AWDerh-Academia/MIE438-Microprocessors-and-Embedded-Microcontrollers/README.md

# Self-Levelling Cup Holder

(For MIE438)

# Authors

Abdul Derh \
Rakshit Sharma \
Tongwha Kim

# Demo

[YouTube Video](https://www.youtube.com/watch?v=ZMVGCV2L7J8&feature=youtu.be)
