AWDerh-Academia/MIE438-Microprocessors-and-Embedded-Microcontrollers/dis.asm

slc-vs.ino.elf:     file format elf32-avr


Disassembly of section .text:

00000000 <__vectors>:
       0:	1e c1       	rjmp	.+572    	; 0x23e <__ctors_end>
       2:	00 00       	nop
       4:	4d c1       	rjmp	.+666    	; 0x2a0 <__bad_interrupt>
       6:	00 00       	nop
       8:	4b c1       	rjmp	.+662    	; 0x2a0 <__bad_interrupt>
       a:	00 00       	nop
       c:	49 c1       	rjmp	.+658    	; 0x2a0 <__bad_interrupt>
       e:	00 00       	nop
      10:	47 c1       	rjmp	.+654    	; 0x2a0 <__bad_interrupt>
      12:	00 00       	nop
      14:	45 c1       	rjmp	.+650    	; 0x2a0 <__bad_interrupt>
      16:	00 00       	nop
      18:	43 c1       	rjmp	.+646    	; 0x2a0 <__bad_interrupt>
      1a:	00 00       	nop
      1c:	41 c1       	rjmp	.+642    	; 0x2a0 <__bad_interrupt>
      1e:	00 00       	nop
      20:	3f c1       	rjmp	.+638    	; 0x2a0 <__bad_interrupt>
      22:	00 00       	nop
      24:	3d c1       	rjmp	.+634    	; 0x2a0 <__bad_interrupt>
      26:	00 00       	nop
      28:	3b c1       	rjmp	.+630    	; 0x2a0 <__bad_interrupt>
      2a:	00 00       	nop
      2c:	39 c1       	rjmp	.+626    	; 0x2a0 <__bad_interrupt>
      2e:	00 00       	nop
      30:	37 c1       	rjmp	.+622    	; 0x2a0 <__bad_interrupt>
      32:	00 00       	nop
      34:	35 c1       	rjmp	.+618    	; 0x2a0 <__bad_interrupt>
      36:	00 00       	nop
      38:	33 c1       	rjmp	.+614    	; 0x2a0 <__bad_interrupt>
      3a:	00 00       	nop
      3c:	31 c1       	rjmp	.+610    	; 0x2a0 <__bad_interrupt>
      3e:	00 00       	nop
      40:	2f c1       	rjmp	.+606    	; 0x2a0 <__bad_interrupt>
      42:	00 00       	nop
      44:	03 c7       	rjmp	.+3590   	; 0xe4c <__vector_17>
      46:	00 00       	nop
      48:	2b c1       	rjmp	.+598    	; 0x2a0 <__bad_interrupt>
      4a:	00 00       	nop
      4c:	29 c1       	rjmp	.+594    	; 0x2a0 <__bad_interrupt>
      4e:	00 00       	nop
      50:	27 c1       	rjmp	.+590    	; 0x2a0 <__bad_interrupt>
      52:	00 00       	nop
      54:	25 c1       	rjmp	.+586    	; 0x2a0 <__bad_interrupt>
      56:	00 00       	nop
      58:	23 c1       	rjmp	.+582    	; 0x2a0 <__bad_interrupt>
      5a:	00 00       	nop
      5c:	26 c6       	rjmp	.+3148   	; 0xcaa <__vector_23>
      5e:	00 00       	nop
      60:	1f c1       	rjmp	.+574    	; 0x2a0 <__bad_interrupt>
      62:	00 00       	nop
      64:	ec c5       	rjmp	.+3032   	; 0xc3e <__vector_25>
      66:	00 00       	nop
      68:	c1 c5       	rjmp	.+2946   	; 0xbec <__vector_26>
      6a:	00 00       	nop
      6c:	19 c1       	rjmp	.+562    	; 0x2a0 <__bad_interrupt>
      6e:	00 00       	nop
      70:	17 c1       	rjmp	.+558    	; 0x2a0 <__bad_interrupt>
      72:	00 00       	nop
      74:	15 c1       	rjmp	.+554    	; 0x2a0 <__bad_interrupt>
      76:	00 00       	nop
      78:	13 c1       	rjmp	.+550    	; 0x2a0 <__bad_interrupt>
      7a:	00 00       	nop
      7c:	11 c1       	rjmp	.+546    	; 0x2a0 <__bad_interrupt>
      7e:	00 00       	nop
      80:	b8 c6       	rjmp	.+3440   	; 0xdf2 <__vector_32>
      82:	00 00       	nop
      84:	0d c1       	rjmp	.+538    	; 0x2a0 <__bad_interrupt>
      86:	00 00       	nop
      88:	0b c1       	rjmp	.+534    	; 0x2a0 <__bad_interrupt>
      8a:	00 00       	nop
      8c:	09 c1       	rjmp	.+530    	; 0x2a0 <__bad_interrupt>
      8e:	00 00       	nop
      90:	07 c1       	rjmp	.+526    	; 0x2a0 <__bad_interrupt>
      92:	00 00       	nop
      94:	05 c1       	rjmp	.+522    	; 0x2a0 <__bad_interrupt>
      96:	00 00       	nop
      98:	03 c1       	rjmp	.+518    	; 0x2a0 <__bad_interrupt>
      9a:	00 00       	nop
      9c:	04 c7       	rjmp	.+3592   	; 0xea6 <__vector_39>
      9e:	00 00       	nop
      a0:	ff c0       	rjmp	.+510    	; 0x2a0 <__bad_interrupt>
      a2:	00 00       	nop
      a4:	fd c0       	rjmp	.+506    	; 0x2a0 <__bad_interrupt>
      a6:	00 00       	nop
      a8:	77 c6       	rjmp	.+3310   	; 0xd98 <__vector_42>
      aa:	00 00       	nop
      ac:	f9 c0       	rjmp	.+498    	; 0x2a0 <__bad_interrupt>
      ae:	00 00       	nop
      b0:	f7 c0       	rjmp	.+494    	; 0x2a0 <__bad_interrupt>
      b2:	00 00       	nop
      b4:	f5 c0       	rjmp	.+490    	; 0x2a0 <__bad_interrupt>
      b6:	00 00       	nop
      b8:	f3 c0       	rjmp	.+486    	; 0x2a0 <__bad_interrupt>
      ba:	00 00       	nop
      bc:	40 c6       	rjmp	.+3200   	; 0xd3e <__vector_47>
      be:	00 00       	nop
      c0:	ef c0       	rjmp	.+478    	; 0x2a0 <__bad_interrupt>
      c2:	00 00       	nop
      c4:	ed c0       	rjmp	.+474    	; 0x2a0 <__bad_interrupt>
      c6:	00 00       	nop
      c8:	eb c0       	rjmp	.+470    	; 0x2a0 <__bad_interrupt>
      ca:	00 00       	nop
      cc:	e9 c0       	rjmp	.+466    	; 0x2a0 <__bad_interrupt>
      ce:	00 00       	nop
      d0:	e7 c0       	rjmp	.+462    	; 0x2a0 <__bad_interrupt>
      d2:	00 00       	nop
      d4:	e5 c0       	rjmp	.+458    	; 0x2a0 <__bad_interrupt>
      d6:	00 00       	nop
      d8:	e3 c0       	rjmp	.+454    	; 0x2a0 <__bad_interrupt>
      da:	00 00       	nop
      dc:	e1 c0       	rjmp	.+450    	; 0x2a0 <__bad_interrupt>
      de:	00 00       	nop
      e0:	df c0       	rjmp	.+446    	; 0x2a0 <__bad_interrupt>
      e2:	00 00       	nop
      e4:	8f 02       	muls	r24, r31
      e6:	92 02       	muls	r25, r18
      e8:	81 02       	muls	r24, r17
      ea:	85 02       	muls	r24, r21
      ec:	89 02       	muls	r24, r25
      ee:	c9 02       	muls	r28, r25
      f0:	96 02       	muls	r25, r22
      f2:	9a 02       	muls	r25, r26
      f4:	a0 02       	muls	r26, r16
      f6:	a4 02       	muls	r26, r20
      f8:	a8 02       	muls	r26, r24
      fa:	ae 02       	muls	r26, r30
      fc:	b2 02       	muls	r27, r18
      fe:	b6 02       	muls	r27, r22
     100:	c9 02       	muls	r28, r25
     102:	bc 02       	muls	r27, r28
     104:	c0 02       	muls	r28, r16
     106:	c4 02       	muls	r28, r20
     108:	08 4a       	sbci	r16, 0xA8	; 168
     10a:	d7 3b       	cpi	r29, 0xB7	; 183
     10c:	3b ce       	rjmp	.-906    	; 0xfffffd84 <__eeprom_end+0xff7efd84>
     10e:	01 6e       	ori	r16, 0xE1	; 225
     110:	84 bc       	out	0x24, r8	; 36
     112:	bf fd       	.word	0xfdbf	; ????
     114:	c1 2f       	mov	r28, r17
     116:	3d 6c       	ori	r19, 0xCD	; 205
     118:	74 31       	cpi	r23, 0x14	; 20
     11a:	9a bd       	out	0x2a, r25	; 42
     11c:	56 83       	std	Z+6, r21	; 0x06
     11e:	3d da       	rcall	.-2950   	; 0xfffff59a <__eeprom_end+0xff7ef59a>
     120:	3d 00       	.word	0x003d	; ????
     122:	c7 7f       	andi	r28, 0xF7	; 247
     124:	11 be       	out	0x31, r1	; 49
     126:	d9 e4       	ldi	r29, 0x49	; 73
     128:	bb 4c       	sbci	r27, 0xCB	; 203
     12a:	3e 91       	ld	r19, -X
     12c:	6b aa       	std	Y+51, r6	; 0x33
     12e:	aa be       	out	0x3a, r10	; 58
     130:	00 00       	nop
     132:	00 80       	ld	r0, Z
     134:	3f 00       	.word	0x003f	; ????

00000136 <__trampolines_end>:
     136:	00 00       	nop
     138:	21 00       	.word	0x0021	; ????
     13a:	24 00       	.word	0x0024	; ????
     13c:	27 00       	.word	0x0027	; ????
     13e:	2a 00       	.word	0x002a	; ????
     140:	2d 00       	.word	0x002d	; ????
     142:	30 00       	.word	0x0030	; ????
     144:	33 00       	.word	0x0033	; ????
     146:	01 01       	movw	r0, r2
     148:	00 00       	nop
     14a:	04 01       	movw	r0, r8
     14c:	07 01       	movw	r0, r14
     14e:	0a 01       	movw	r0, r20

00000150 <port_to_output_PGM>:
     150:	00 00 22 00 25 00 28 00 2b 00 2e 00 31 00 34 00     ..".%.(.+...1.4.
     160:	02 01 00 00 05 01 08 01 0b 01                       ..........

0000016a <digital_pin_to_port_PGM>:
     16a:	05 05 05 05 07 05 08 08 08 08 02 02 02 02 0a 0a     ................
     17a:	08 08 04 04 04 04 01 01 01 01 01 01 01 01 03 03     ................
     18a:	03 03 03 03 03 03 04 07 07 07 0c 0c 0c 0c 0c 0c     ................
     19a:	0c 0c 02 02 02 02 06 06 06 06 06 06 06 06 0b 0b     ................
     1aa:	0b 0b 0b 0b 0b 0b                                   ......

000001b0 <digital_pin_to_bit_mask_PGM>:
     1b0:	01 02 10 20 20 08 08 10 20 40 10 20 40 80 02 01     ...  ... @. @...
     1c0:	02 01 08 04 02 01 01 02 04 08 10 20 40 80 80 40     ........... @..@
     1d0:	20 10 08 04 02 01 80 04 02 01 80 40 20 10 08 04      ..........@ ...
     1e0:	02 01 08 04 02 01 01 02 04 08 10 20 40 80 01 02     ........... @...
     1f0:	04 08 10 20 40 80                                   ... @.

000001f6 <digital_pin_to_timer_PGM>:
     1f6:	00 00 0a 0b 02 09 0c 0d 0e 08 07 03 04 01 00 00     ................
     206:	00 00 00 00 00 00 00 00 00 00 00 00 00 00 00 00     ................
     216:	00 00 00 00 00 00 00 00 00 00 00 00 12 11 10 00     ................
     226:	00 00 00 00 00 00 00 00 00 00 00 00 00 00 00 00     ................
     236:	00 00 00 00 00 00                                   ......

0000023c <__ctors_start>:
     23c:	24 0c       	add	r2, r4

0000023e <__ctors_end>:
     23e:	11 24       	eor	r1, r1
     240:	1f be       	out	0x3f, r1	; 63
     242:	cf ef       	ldi	r28, 0xFF	; 255
     244:	d1 e2       	ldi	r29, 0x21	; 33
     246:	de bf       	out	0x3e, r29	; 62
     248:	cd bf       	out	0x3d, r28	; 61
     24a:	00 e0       	ldi	r16, 0x00	; 0
     24c:	0c bf       	out	0x3c, r16	; 60

0000024e <__do_copy_data>:
     24e:	12 e0       	ldi	r17, 0x02	; 2
     250:	a0 e0       	ldi	r26, 0x00	; 0
     252:	b2 e0       	ldi	r27, 0x02	; 2
     254:	e8 ef       	ldi	r30, 0xF8	; 248
     256:	ff e1       	ldi	r31, 0x1F	; 31
     258:	00 e0       	ldi	r16, 0x00	; 0
     25a:	0b bf       	out	0x3b, r16	; 59
     25c:	02 c0       	rjmp	.+4      	; 0x262 <__do_copy_data+0x14>
     25e:	07 90       	elpm	r0, Z+
     260:	0d 92       	st	X+, r0
     262:	ac 32       	cpi	r26, 0x2C	; 44
     264:	b1 07       	cpc	r27, r17
     266:	d9 f7       	brne	.-10     	; 0x25e <__do_copy_data+0x10>

00000268 <__do_clear_bss>:
     268:	24 e0       	ldi	r18, 0x04	; 4
     26a:	ac e2       	ldi	r26, 0x2C	; 44
     26c:	b2 e0       	ldi	r27, 0x02	; 2
     26e:	01 c0       	rjmp	.+2      	; 0x272 <.do_clear_bss_start>

00000270 <.do_clear_bss_loop>:
     270:	1d 92       	st	X+, r1

00000272 <.do_clear_bss_start>:
     272:	a6 34       	cpi	r26, 0x46	; 70
     274:	b2 07       	cpc	r27, r18
     276:	e1 f7       	brne	.-8      	; 0x270 <.do_clear_bss_loop>

00000278 <__do_global_ctors>:
     278:	11 e0       	ldi	r17, 0x01	; 1
     27a:	cf e1       	ldi	r28, 0x1F	; 31
     27c:	d1 e0       	ldi	r29, 0x01	; 1
     27e:	00 e0       	ldi	r16, 0x00	; 0
     280:	06 c0       	rjmp	.+12     	; 0x28e <__do_global_ctors+0x16>
     282:	21 97       	sbiw	r28, 0x01	; 1
     284:	01 09       	sbc	r16, r1
     286:	80 2f       	mov	r24, r16
     288:	fe 01       	movw	r30, r28
     28a:	0e 94 ee 0f 	call	0x1fdc	; 0x1fdc <__tablejump2__>
     28e:	ce 31       	cpi	r28, 0x1E	; 30
     290:	d1 07       	cpc	r29, r17
     292:	80 e0       	ldi	r24, 0x00	; 0
     294:	08 07       	cpc	r16, r24
     296:	a9 f7       	brne	.-22     	; 0x282 <__do_global_ctors+0xa>
     298:	0e 94 0e 0a 	call	0x141c	; 0x141c <main>
     29c:	0c 94 fa 0f 	jmp	0x1ff4	; 0x1ff4 <_exit>

000002a0 <__bad_interrupt>:
     2a0:	af ce       	rjmp	.-674    	; 0x0 <__vectors>

000002a2 <_ZN7TwoWire16onRequestServiceEv>:
  user_onReceive(numBytes);
}

// behind the scenes function that is called when data is requested
void TwoWire::onRequestService(void)
{
     2a2:	08 95       	ret

000002a4 <_ZN7TwoWire16onReceiveServiceEPhi>:
  // XXX: to be implemented.
}

// behind the scenes function that is called when data is received
void TwoWire::onReceiveService(uint8_t* inBytes, int numBytes)
{
     2a4:	08 95       	ret

000002a6 <_ZN14HardwareSerial17availableForWriteEv>:
{
  tx_buffer_index_t head;
  tx_buffer_index_t tail;

  TX_BUFFER_ATOMIC {
    head = _tx_buffer_head;
     2a6:	fc 01       	movw	r30, r24
     2a8:	53 8d       	ldd	r21, Z+27	; 0x1b
    tail = _tx_buffer_tail;
     2aa:	44 8d       	ldd	r20, Z+28	; 0x1c
     2ac:	25 2f       	mov	r18, r21
     2ae:	30 e0       	ldi	r19, 0x00	; 0
     2b0:	84 2f       	mov	r24, r20
     2b2:	90 e0       	ldi	r25, 0x00	; 0
  }
  if (head >= tail) return SERIAL_TX_BUFFER_SIZE - 1 - head + tail;
     2b4:	82 1b       	sub	r24, r18
     2b6:	93 0b       	sbc	r25, r19
     2b8:	54 17       	cp	r21, r20
     2ba:	10 f0       	brcs	.+4      	; 0x2c0 <_ZN14HardwareSerial17availableForWriteEv+0x1a>
     2bc:	cf 96       	adiw	r24, 0x3f	; 63
     2be:	08 95       	ret
  return tail - head - 1;
     2c0:	01 97       	sbiw	r24, 0x01	; 1
}
     2c2:	08 95       	ret

000002c4 <_ZN14HardwareSerial4readEv>:
    return _rx_buffer[_rx_buffer_tail];
  }
}

int HardwareSerial::read(void)
{
     2c4:	fc 01       	movw	r30, r24
  // if the head isn't ahead of the tail, we don't have any characters
  if (_rx_buffer_head == _rx_buffer_tail) {
     2c6:	91 8d       	ldd	r25, Z+25	; 0x19
     2c8:	82 8d       	ldd	r24, Z+26	; 0x1a
     2ca:	98 17       	cp	r25, r24
     2cc:	61 f0       	breq	.+24     	; 0x2e6 <_ZN14HardwareSerial4readEv+0x22>
    return -1;
  } else {
    unsigned char c = _rx_buffer[_rx_buffer_tail];
     2ce:	82 8d       	ldd	r24, Z+26	; 0x1a
     2d0:	df 01       	movw	r26, r30
     2d2:	a8 0f       	add	r26, r24
     2d4:	b1 1d       	adc	r27, r1
     2d6:	5d 96       	adiw	r26, 0x1d	; 29
     2d8:	8c 91       	ld	r24, X
    _rx_buffer_tail = (rx_buffer_index_t)(_rx_buffer_tail + 1) % SERIAL_RX_BUFFER_SIZE;
     2da:	92 8d       	ldd	r25, Z+26	; 0x1a
     2dc:	9f 5f       	subi	r25, 0xFF	; 255
     2de:	9f 73       	andi	r25, 0x3F	; 63
     2e0:	92 8f       	std	Z+26, r25	; 0x1a
    return c;
     2e2:	90 e0       	ldi	r25, 0x00	; 0
     2e4:	08 95       	ret

int HardwareSerial::read(void)
{
  // if the head isn't ahead of the tail, we don't have any characters
  if (_rx_buffer_head == _rx_buffer_tail) {
    return -1;
     2e6:	8f ef       	ldi	r24, 0xFF	; 255
     2e8:	9f ef       	ldi	r25, 0xFF	; 255
  } else {
    unsigned char c = _rx_buffer[_rx_buffer_tail];
    _rx_buffer_tail = (rx_buffer_index_t)(_rx_buffer_tail + 1) % SERIAL_RX_BUFFER_SIZE;
    return c;
  }
}
     2ea:	08 95       	ret

000002ec <_ZN14HardwareSerial4peekEv>:
{
  return ((unsigned int)(SERIAL_RX_BUFFER_SIZE + _rx_buffer_head - _rx_buffer_tail)) % SERIAL_RX_BUFFER_SIZE;
}

int HardwareSerial::peek(void)
{
     2ec:	fc 01       	movw	r30, r24
  if (_rx_buffer_head == _rx_buffer_tail) {
     2ee:	91 8d       	ldd	r25, Z+25	; 0x19
     2f0:	82 8d       	ldd	r24, Z+26	; 0x1a
     2f2:	98 17       	cp	r25, r24
     2f4:	31 f0       	breq	.+12     	; 0x302 <_ZN14HardwareSerial4peekEv+0x16>
    return -1;
  } else {
    return _rx_buffer[_rx_buffer_tail];
     2f6:	82 8d       	ldd	r24, Z+26	; 0x1a
     2f8:	e8 0f       	add	r30, r24
     2fa:	f1 1d       	adc	r31, r1
     2fc:	85 8d       	ldd	r24, Z+29	; 0x1d
     2fe:	90 e0       	ldi	r25, 0x00	; 0
     300:	08 95       	ret
}

int HardwareSerial::peek(void)
{
  if (_rx_buffer_head == _rx_buffer_tail) {
    return -1;
     302:	8f ef       	ldi	r24, 0xFF	; 255
     304:	9f ef       	ldi	r25, 0xFF	; 255
  } else {
    return _rx_buffer[_rx_buffer_tail];
  }
}
     306:	08 95       	ret

00000308 <_ZN14HardwareSerial9availableEv>:
  // clear any received data
  _rx_buffer_head = _rx_buffer_tail;
}

int HardwareSerial::available(void)
{
     308:	fc 01       	movw	r30, r24
  return ((unsigned int)(SERIAL_RX_BUFFER_SIZE + _rx_buffer_head - _rx_buffer_tail)) % SERIAL_RX_BUFFER_SIZE;
     30a:	91 8d       	ldd	r25, Z+25	; 0x19
     30c:	22 8d       	ldd	r18, Z+26	; 0x1a
     30e:	89 2f       	mov	r24, r25
     310:	90 e0       	ldi	r25, 0x00	; 0
     312:	80 5c       	subi	r24, 0xC0	; 192
     314:	9f 4f       	sbci	r25, 0xFF	; 255
     316:	82 1b       	sub	r24, r18
     318:	91 09       	sbc	r25, r1
}
     31a:	8f 73       	andi	r24, 0x3F	; 63
     31c:	99 27       	eor	r25, r25
     31e:	08 95       	ret

00000320 <_Z17Serial0_availablev>:
#endif

// Function that can be weakly referenced by serialEventRun to prevent
// pulling in this file if it's not otherwise used.
bool Serial0_available() {
  return Serial.available();
     320:	87 ef       	ldi	r24, 0xF7	; 247
     322:	92 e0       	ldi	r25, 0x02	; 2
     324:	f1 df       	rcall	.-30     	; 0x308 <_ZN14HardwareSerial9availableEv>
     326:	21 e0       	ldi	r18, 0x01	; 1
     328:	89 2b       	or	r24, r25
     32a:	09 f4       	brne	.+2      	; 0x32e <_Z17Serial0_availablev+0xe>
     32c:	20 e0       	ldi	r18, 0x00	; 0
}
     32e:	82 2f       	mov	r24, r18
     330:	08 95       	ret

00000332 <_ZN14HardwareSerial17_tx_udr_empty_irqEv>:
#endif

// Actual interrupt handlers //////////////////////////////////////////////////////////////

void HardwareSerial::_tx_udr_empty_irq(void)
{
     332:	fc 01       	movw	r30, r24
  // If interrupts are enabled, there must be more data in the output
  // buffer. Send the next byte
  unsigned char c = _tx_buffer[_tx_buffer_tail];
     334:	84 8d       	ldd	r24, Z+28	; 0x1c
     336:	df 01       	movw	r26, r30
     338:	a8 0f       	add	r26, r24
     33a:	b1 1d       	adc	r27, r1
     33c:	a3 5a       	subi	r26, 0xA3	; 163
     33e:	bf 4f       	sbci	r27, 0xFF	; 255
     340:	2c 91       	ld	r18, X
  _tx_buffer_tail = (_tx_buffer_tail + 1) % SERIAL_TX_BUFFER_SIZE;
     342:	84 8d       	ldd	r24, Z+28	; 0x1c
     344:	90 e0       	ldi	r25, 0x00	; 0
     346:	01 96       	adiw	r24, 0x01	; 1
     348:	8f 73       	andi	r24, 0x3F	; 63
     34a:	99 27       	eor	r25, r25
     34c:	84 8f       	std	Z+28, r24	; 0x1c

  *_udr = c;
     34e:	a6 89       	ldd	r26, Z+22	; 0x16
     350:	b7 89       	ldd	r27, Z+23	; 0x17
     352:	2c 93       	st	X, r18
  // location". This makes sure flush() won't return until the bytes
  // actually got written. Other r/w bits are preserved, and zeroes
  // written to the rest.

#ifdef MPCM0
  *_ucsra = ((*_ucsra) & ((1 << U2X0) | (1 << MPCM0))) | (1 << TXC0);
     354:	a0 89       	ldd	r26, Z+16	; 0x10
     356:	b1 89       	ldd	r27, Z+17	; 0x11
     358:	8c 91       	ld	r24, X
     35a:	83 70       	andi	r24, 0x03	; 3
     35c:	80 64       	ori	r24, 0x40	; 64
     35e:	8c 93       	st	X, r24
#else
  *_ucsra = ((*_ucsra) & ((1 << U2X0) | (1 << TXC0)));
#endif

  if (_tx_buffer_head == _tx_buffer_tail) {
     360:	93 8d       	ldd	r25, Z+27	; 0x1b
     362:	84 8d       	ldd	r24, Z+28	; 0x1c
     364:	98 13       	cpse	r25, r24
     366:	06 c0       	rjmp	.+12     	; 0x374 <_ZN14HardwareSerial17_tx_udr_empty_irqEv+0x42>
    // Buffer empty, so disable interrupts
    cbi(*_ucsrb, UDRIE0);
     368:	02 88       	ldd	r0, Z+18	; 0x12
     36a:	f3 89       	ldd	r31, Z+19	; 0x13
     36c:	e0 2d       	mov	r30, r0
     36e:	80 81       	ld	r24, Z
     370:	8f 7d       	andi	r24, 0xDF	; 223
     372:	80 83       	st	Z, r24
     374:	08 95       	ret

00000376 <_ZN14HardwareSerial5writeEh>:
  // If we get here, nothing is queued anymore (DRIE is disabled) and
  // the hardware finished tranmission (TXC is set).
}

size_t HardwareSerial::write(uint8_t c)
{
     376:	ef 92       	push	r14
     378:	ff 92       	push	r15
     37a:	0f 93       	push	r16
     37c:	1f 93       	push	r17
     37e:	cf 93       	push	r28
     380:	df 93       	push	r29
     382:	ec 01       	movw	r28, r24
  _written = true;
     384:	81 e0       	ldi	r24, 0x01	; 1
     386:	88 8f       	std	Y+24, r24	; 0x18
  // If the buffer and the data register is empty, just write the byte
  // to the data register and be done. This shortcut helps
  // significantly improve the effective datarate at high (>
  // 500kbit/s) bitrates, where interrupt overhead becomes a slowdown.
  if (_tx_buffer_head == _tx_buffer_tail && bit_is_set(*_ucsra, UDRE0)) {
     388:	9b 8d       	ldd	r25, Y+27	; 0x1b
     38a:	8c 8d       	ldd	r24, Y+28	; 0x1c
     38c:	98 13       	cpse	r25, r24
     38e:	05 c0       	rjmp	.+10     	; 0x39a <_ZN14HardwareSerial5writeEh+0x24>
     390:	e8 89       	ldd	r30, Y+16	; 0x10
     392:	f9 89       	ldd	r31, Y+17	; 0x11
     394:	80 81       	ld	r24, Z
     396:	85 fd       	sbrc	r24, 5
     398:	25 c0       	rjmp	.+74     	; 0x3e4 <_ZN14HardwareSerial5writeEh+0x6e>
     39a:	f6 2e       	mov	r15, r22
      *_ucsra = ((*_ucsra) & ((1 << U2X0) | (1 << TXC0)));
#endif
    }
    return 1;
  }
  tx_buffer_index_t i = (_tx_buffer_head + 1) % SERIAL_TX_BUFFER_SIZE;
     39c:	0b 8d       	ldd	r16, Y+27	; 0x1b
     39e:	10 e0       	ldi	r17, 0x00	; 0
     3a0:	0f 5f       	subi	r16, 0xFF	; 255
     3a2:	1f 4f       	sbci	r17, 0xFF	; 255
     3a4:	0f 73       	andi	r16, 0x3F	; 63
     3a6:	11 27       	eor	r17, r17
     3a8:	e0 2e       	mov	r14, r16
	
  // If the output buffer is full, there's nothing for it other than to 
  // wait for the interrupt handler to empty it a bit
  while (i == _tx_buffer_tail) {
     3aa:	8c 8d       	ldd	r24, Y+28	; 0x1c
     3ac:	e8 12       	cpse	r14, r24
     3ae:	0b c0       	rjmp	.+22     	; 0x3c6 <_ZN14HardwareSerial5writeEh+0x50>
    if (bit_is_clear(SREG, SREG_I)) {
     3b0:	0f b6       	in	r0, 0x3f	; 63
     3b2:	07 fc       	sbrc	r0, 7
     3b4:	fa cf       	rjmp	.-12     	; 0x3aa <_ZN14HardwareSerial5writeEh+0x34>
      // Interrupts are disabled, so we'll have to poll the data
      // register empty flag ourselves. If it is set, pretend an
      // interrupt has happened and call the handler to free up
      // space for us.
      if(bit_is_set(*_ucsra, UDRE0))
     3b6:	e8 89       	ldd	r30, Y+16	; 0x10
     3b8:	f9 89       	ldd	r31, Y+17	; 0x11
     3ba:	80 81       	ld	r24, Z
     3bc:	85 ff       	sbrs	r24, 5
     3be:	f5 cf       	rjmp	.-22     	; 0x3aa <_ZN14HardwareSerial5writeEh+0x34>
	_tx_udr_empty_irq();
     3c0:	ce 01       	movw	r24, r28
     3c2:	b7 df       	rcall	.-146    	; 0x332 <_ZN14HardwareSerial17_tx_udr_empty_irqEv>
     3c4:	f2 cf       	rjmp	.-28     	; 0x3aa <_ZN14HardwareSerial5writeEh+0x34>
    } else {
      // nop, the interrupt handler will free up space for us
    }
  }

  _tx_buffer[_tx_buffer_head] = c;
     3c6:	8b 8d       	ldd	r24, Y+27	; 0x1b
     3c8:	fe 01       	movw	r30, r28
     3ca:	e8 0f       	add	r30, r24
     3cc:	f1 1d       	adc	r31, r1
     3ce:	e3 5a       	subi	r30, 0xA3	; 163
     3d0:	ff 4f       	sbci	r31, 0xFF	; 255
     3d2:	f0 82       	st	Z, r15

  // make atomic to prevent execution of ISR between setting the
  // head pointer and setting the interrupt flag resulting in buffer
  // retransmission
  ATOMIC_BLOCK(ATOMIC_RESTORESTATE) {
     3d4:	9f b7       	in	r25, 0x3f	; 63
    return 1;
}

static __inline__ uint8_t __iCliRetVal(void)
{
    cli();
     3d6:	f8 94       	cli
    _tx_buffer_head = i;
     3d8:	0b 8f       	std	Y+27, r16	; 0x1b
    sbi(*_ucsrb, UDRIE0);
     3da:	ea 89       	ldd	r30, Y+18	; 0x12
     3dc:	fb 89       	ldd	r31, Y+19	; 0x13
     3de:	80 81       	ld	r24, Z
     3e0:	80 62       	ori	r24, 0x20	; 32
     3e2:	0a c0       	rjmp	.+20     	; 0x3f8 <_ZN14HardwareSerial5writeEh+0x82>
    // So writing UDR must happen first.
    // Writing UDR and clearing TC must be done atomically, otherwise
    // interrupts might delay the TXC clear so the byte written to UDR
    // is transmitted (setting TXC) before clearing TXC. Then TXC will
    // be cleared when no bytes are left, causing flush() to hang
    ATOMIC_BLOCK(ATOMIC_RESTORESTATE) {
     3e4:	9f b7       	in	r25, 0x3f	; 63
     3e6:	f8 94       	cli
      *_udr = c;
     3e8:	ee 89       	ldd	r30, Y+22	; 0x16
     3ea:	ff 89       	ldd	r31, Y+23	; 0x17
     3ec:	60 83       	st	Z, r22
#ifdef MPCM0
      *_ucsra = ((*_ucsra) & ((1 << U2X0) | (1 << MPCM0))) | (1 << TXC0);
     3ee:	e8 89       	ldd	r30, Y+16	; 0x10
     3f0:	f9 89       	ldd	r31, Y+17	; 0x11
     3f2:	80 81       	ld	r24, Z
     3f4:	83 70       	andi	r24, 0x03	; 3
     3f6:	80 64       	ori	r24, 0x40	; 64
     3f8:	80 83       	st	Z, r24
    (void)__s;
}

static __inline__ void __iRestore(const  uint8_t *__s)
{
    SREG = *__s;
     3fa:	9f bf       	out	0x3f, r25	; 63
    _tx_buffer_head = i;
    sbi(*_ucsrb, UDRIE0);
  }
  
  return 1;
}
     3fc:	81 e0       	ldi	r24, 0x01	; 1
     3fe:	90 e0       	ldi	r25, 0x00	; 0
     400:	df 91       	pop	r29
     402:	cf 91       	pop	r28
     404:	1f 91       	pop	r17
     406:	0f 91       	pop	r16
     408:	ff 90       	pop	r15
     40a:	ef 90       	pop	r14
     40c:	08 95       	ret

0000040e <_ZN14HardwareSerial5flushEv>:
  if (head >= tail) return SERIAL_TX_BUFFER_SIZE - 1 - head + tail;
  return tail - head - 1;
}

void HardwareSerial::flush()
{
     40e:	cf 93       	push	r28
     410:	df 93       	push	r29
     412:	ec 01       	movw	r28, r24
  // If we have never written a byte, no need to flush. This special
  // case is needed since there is no way to force the TXC (transmit
  // complete) bit to 1 during initialization
  if (!_written)
     414:	88 8d       	ldd	r24, Y+24	; 0x18
     416:	88 23       	and	r24, r24
     418:	c1 f0       	breq	.+48     	; 0x44a <_ZN14HardwareSerial5flushEv+0x3c>
    return;

  while (bit_is_set(*_ucsrb, UDRIE0) || bit_is_clear(*_ucsra, TXC0)) {
     41a:	ea 89       	ldd	r30, Y+18	; 0x12
     41c:	fb 89       	ldd	r31, Y+19	; 0x13
     41e:	80 81       	ld	r24, Z
     420:	85 fd       	sbrc	r24, 5
     422:	05 c0       	rjmp	.+10     	; 0x42e <_ZN14HardwareSerial5flushEv+0x20>
     424:	a8 89       	ldd	r26, Y+16	; 0x10
     426:	b9 89       	ldd	r27, Y+17	; 0x11
     428:	8c 91       	ld	r24, X
     42a:	86 fd       	sbrc	r24, 6
     42c:	0e c0       	rjmp	.+28     	; 0x44a <_ZN14HardwareSerial5flushEv+0x3c>
    if (bit_is_clear(SREG, SREG_I) && bit_is_set(*_ucsrb, UDRIE0))
     42e:	0f b6       	in	r0, 0x3f	; 63
     430:	07 fc       	sbrc	r0, 7
     432:	f5 cf       	rjmp	.-22     	; 0x41e <_ZN14HardwareSerial5flushEv+0x10>
     434:	80 81       	ld	r24, Z
     436:	85 ff       	sbrs	r24, 5
     438:	f2 cf       	rjmp	.-28     	; 0x41e <_ZN14HardwareSerial5flushEv+0x10>
	// Interrupts are globally disabled, but the DR empty
	// interrupt should be enabled, so poll the DR empty flag to
	// prevent deadlock
	if (bit_is_set(*_ucsra, UDRE0))
     43a:	a8 89       	ldd	r26, Y+16	; 0x10
     43c:	b9 89       	ldd	r27, Y+17	; 0x11
     43e:	8c 91       	ld	r24, X
     440:	85 ff       	sbrs	r24, 5
	  _tx_udr_empty_irq();
     442:	ed cf       	rjmp	.-38     	; 0x41e <_ZN14HardwareSerial5flushEv+0x10>
     444:	ce 01       	movw	r24, r28
     446:	75 df       	rcall	.-278    	; 0x332 <_ZN14HardwareSerial17_tx_udr_empty_irqEv>
     448:	e8 cf       	rjmp	.-48     	; 0x41a <_ZN14HardwareSerial5flushEv+0xc>
  }
  // If we get here, nothing is queued anymore (DRIE is disabled) and
  // the hardware finished tranmission (TXC is set).
}
     44a:	df 91       	pop	r29
     44c:	cf 91       	pop	r28
     44e:	08 95       	ret

00000450 <_Z14serialEventRunv>:
#endif

void serialEventRun(void)
{
#if defined(HAVE_HWSERIAL0)
  if (Serial0_available && serialEvent && Serial0_available()) serialEvent();
     450:	80 e0       	ldi	r24, 0x00	; 0
     452:	90 e0       	ldi	r25, 0x00	; 0
     454:	89 2b       	or	r24, r25
     456:	19 f0       	breq	.+6      	; 0x45e <_Z14serialEventRunv+0xe>
     458:	63 df       	rcall	.-314    	; 0x320 <_Z17Serial0_availablev>
     45a:	81 11       	cpse	r24, r1
     45c:	25 c0       	rjmp	.+74     	; 0x4a8 <_Z14serialEventRunv+0x58>
#endif
#if defined(HAVE_HWSERIAL1)
  if (Serial1_available && serialEvent1 && Serial1_available()) serialEvent1();
     45e:	80 e0       	ldi	r24, 0x00	; 0
     460:	90 e0       	ldi	r25, 0x00	; 0
     462:	89 2b       	or	r24, r25
     464:	41 f0       	breq	.+16     	; 0x476 <_Z14serialEventRunv+0x26>
     466:	80 e0       	ldi	r24, 0x00	; 0
     468:	90 e0       	ldi	r25, 0x00	; 0
     46a:	89 2b       	or	r24, r25
     46c:	21 f0       	breq	.+8      	; 0x476 <_Z14serialEventRunv+0x26>
     46e:	0e 94 00 00 	call	0	; 0x0 <__vectors>
     472:	81 11       	cpse	r24, r1
     474:	1c c0       	rjmp	.+56     	; 0x4ae <_Z14serialEventRunv+0x5e>
#endif
#if defined(HAVE_HWSERIAL2)
  if (Serial2_available && serialEvent2 && Serial2_available()) serialEvent2();
     476:	80 e0       	ldi	r24, 0x00	; 0
     478:	90 e0       	ldi	r25, 0x00	; 0
     47a:	89 2b       	or	r24, r25
     47c:	41 f0       	breq	.+16     	; 0x48e <_Z14serialEventRunv+0x3e>
     47e:	80 e0       	ldi	r24, 0x00	; 0
     480:	90 e0       	ldi	r25, 0x00	; 0
     482:	89 2b       	or	r24, r25
     484:	21 f0       	breq	.+8      	; 0x48e <_Z14serialEventRunv+0x3e>
     486:	0e 94 00 00 	call	0	; 0x0 <__vectors>
     48a:	81 11       	cpse	r24, r1
     48c:	13 c0       	rjmp	.+38     	; 0x4b4 <_Z14serialEventRunv+0x64>
#endif
#if defined(HAVE_HWSERIAL3)
  if (Serial3_available && serialEvent3 && Serial3_available()) serialEvent3();
     48e:	80 e0       	ldi	r24, 0x00	; 0
     490:	90 e0       	ldi	r25, 0x00	; 0
     492:	89 2b       	or	r24, r25
     494:	a1 f0       	breq	.+40     	; 0x4be <_Z14serialEventRunv+0x6e>
     496:	80 e0       	ldi	r24, 0x00	; 0
     498:	90 e0       	ldi	r25, 0x00	; 0
     49a:	89 2b       	or	r24, r25
     49c:	81 f0       	breq	.+32     	; 0x4be <_Z14serialEventRunv+0x6e>
     49e:	0e 94 00 00 	call	0	; 0x0 <__vectors>
     4a2:	81 11       	cpse	r24, r1
     4a4:	0a c0       	rjmp	.+20     	; 0x4ba <_Z14serialEventRunv+0x6a>
     4a6:	08 95       	ret
#endif

void serialEventRun(void)
{
#if defined(HAVE_HWSERIAL0)
  if (Serial0_available && serialEvent && Serial0_available()) serialEvent();
     4a8:	0e 94 00 00 	call	0	; 0x0 <__vectors>
     4ac:	d8 cf       	rjmp	.-80     	; 0x45e <_Z14serialEventRunv+0xe>
#endif
#if defined(HAVE_HWSERIAL1)
  if (Serial1_available && serialEvent1 && Serial1_available()) serialEvent1();
     4ae:	0e 94 00 00 	call	0	; 0x0 <__vectors>
     4b2:	e1 cf       	rjmp	.-62     	; 0x476 <_Z14serialEventRunv+0x26>
#endif
#if defined(HAVE_HWSERIAL2)
  if (Serial2_available && serialEvent2 && Serial2_available()) serialEvent2();
     4b4:	0e 94 00 00 	call	0	; 0x0 <__vectors>
     4b8:	ea cf       	rjmp	.-44     	; 0x48e <_Z14serialEventRunv+0x3e>
#endif
#if defined(HAVE_HWSERIAL3)
  if (Serial3_available && serialEvent3 && Serial3_available()) serialEvent3();
     4ba:	0c 94 00 00 	jmp	0	; 0x0 <__vectors>
     4be:	08 95       	ret

000004c0 <digitalWrite>:
		#endif
	}
}

void digitalWrite(uint8_t pin, uint8_t val)
{
     4c0:	36 2f       	mov	r19, r22
	uint8_t timer = digitalPinToTimer(pin);
     4c2:	90 e0       	ldi	r25, 0x00	; 0
     4c4:	fc 01       	movw	r30, r24
     4c6:	ea 50       	subi	r30, 0x0A	; 10
     4c8:	fe 4f       	sbci	r31, 0xFE	; 254
     4ca:	44 91       	lpm	r20, Z
	uint8_t bit = digitalPinToBitMask(pin);
     4cc:	fc 01       	movw	r30, r24
     4ce:	e0 55       	subi	r30, 0x50	; 80
     4d0:	fe 4f       	sbci	r31, 0xFE	; 254
     4d2:	24 91       	lpm	r18, Z
	uint8_t port = digitalPinToPort(pin);
     4d4:	fc 01       	movw	r30, r24
     4d6:	e6 59       	subi	r30, 0x96	; 150
     4d8:	fe 4f       	sbci	r31, 0xFE	; 254
     4da:	94 91       	lpm	r25, Z
	volatile uint8_t *out;

	if (port == NOT_A_PIN) return;
     4dc:	99 23       	and	r25, r25
     4de:	09 f4       	brne	.+2      	; 0x4e2 <digitalWrite+0x22>
     4e0:	6c c0       	rjmp	.+216    	; 0x5ba <digitalWrite+0xfa>

	// If the pin that support PWM output, we need to turn it off
	// before doing a digital write.
	if (timer != NOT_ON_TIMER) turnOffPWM(timer);
     4e2:	44 23       	and	r20, r20
     4e4:	09 f4       	brne	.+2      	; 0x4e8 <digitalWrite+0x28>
     4e6:	55 c0       	rjmp	.+170    	; 0x592 <digitalWrite+0xd2>
//
//static inline void turnOffPWM(uint8_t timer) __attribute__ ((always_inline));
//static inline void turnOffPWM(uint8_t timer)
static void turnOffPWM(uint8_t timer)
{
	switch (timer)
     4e8:	50 e0       	ldi	r21, 0x00	; 0
     4ea:	fa 01       	movw	r30, r20
     4ec:	31 97       	sbiw	r30, 0x01	; 1
     4ee:	e2 31       	cpi	r30, 0x12	; 18
     4f0:	f1 05       	cpc	r31, r1
     4f2:	08 f0       	brcs	.+2      	; 0x4f6 <digitalWrite+0x36>
     4f4:	4e c0       	rjmp	.+156    	; 0x592 <digitalWrite+0xd2>
     4f6:	88 27       	eor	r24, r24
     4f8:	ee 58       	subi	r30, 0x8E	; 142
     4fa:	ff 4f       	sbci	r31, 0xFF	; 255
     4fc:	8f 4f       	sbci	r24, 0xFF	; 255
     4fe:	0c 94 ee 0f 	jmp	0x1fdc	; 0x1fdc <__tablejump2__>
	{
		#if defined(TCCR1A) && defined(COM1A1)
		case TIMER1A:   cbi(TCCR1A, COM1A1);    break;
     502:	80 91 80 00 	lds	r24, 0x0080	; 0x800080 <__TEXT_REGION_LENGTH__+0x700080>
     506:	8f 77       	andi	r24, 0x7F	; 127
     508:	07 c0       	rjmp	.+14     	; 0x518 <digitalWrite+0x58>
		#endif
		#if defined(TCCR1A) && defined(COM1B1)
		case TIMER1B:   cbi(TCCR1A, COM1B1);    break;
     50a:	80 91 80 00 	lds	r24, 0x0080	; 0x800080 <__TEXT_REGION_LENGTH__+0x700080>
     50e:	8f 7d       	andi	r24, 0xDF	; 223
     510:	03 c0       	rjmp	.+6      	; 0x518 <digitalWrite+0x58>
		#endif
		#if defined(TCCR1A) && defined(COM1C1)
		case TIMER1C:   cbi(TCCR1A, COM1C1);    break;
     512:	80 91 80 00 	lds	r24, 0x0080	; 0x800080 <__TEXT_REGION_LENGTH__+0x700080>
     516:	87 7f       	andi	r24, 0xF7	; 247
     518:	80 93 80 00 	sts	0x0080, r24	; 0x800080 <__TEXT_REGION_LENGTH__+0x700080>
     51c:	3a c0       	rjmp	.+116    	; 0x592 <digitalWrite+0xd2>
		#if defined(TCCR2) && defined(COM21)
		case  TIMER2:   cbi(TCCR2, COM21);      break;
		#endif
		
		#if defined(TCCR0A) && defined(COM0A1)
		case  TIMER0A:  cbi(TCCR0A, COM0A1);    break;
     51e:	84 b5       	in	r24, 0x24	; 36
     520:	8f 77       	andi	r24, 0x7F	; 127
     522:	02 c0       	rjmp	.+4      	; 0x528 <digitalWrite+0x68>
		#endif
		
		#if defined(TCCR0A) && defined(COM0B1)
		case  TIMER0B:  cbi(TCCR0A, COM0B1);    break;
     524:	84 b5       	in	r24, 0x24	; 36
     526:	8f 7d       	andi	r24, 0xDF	; 223
     528:	84 bd       	out	0x24, r24	; 36
     52a:	33 c0       	rjmp	.+102    	; 0x592 <digitalWrite+0xd2>
		#endif
		#if defined(TCCR2A) && defined(COM2A1)
		case  TIMER2A:  cbi(TCCR2A, COM2A1);    break;
     52c:	80 91 b0 00 	lds	r24, 0x00B0	; 0x8000b0 <__TEXT_REGION_LENGTH__+0x7000b0>
     530:	8f 77       	andi	r24, 0x7F	; 127
     532:	03 c0       	rjmp	.+6      	; 0x53a <digitalWrite+0x7a>
		#endif
		#if defined(TCCR2A) && defined(COM2B1)
		case  TIMER2B:  cbi(TCCR2A, COM2B1);    break;
     534:	80 91 b0 00 	lds	r24, 0x00B0	; 0x8000b0 <__TEXT_REGION_LENGTH__+0x7000b0>
     538:	8f 7d       	andi	r24, 0xDF	; 223
     53a:	80 93 b0 00 	sts	0x00B0, r24	; 0x8000b0 <__TEXT_REGION_LENGTH__+0x7000b0>
     53e:	29 c0       	rjmp	.+82     	; 0x592 <digitalWrite+0xd2>
		#endif
		
		#if defined(TCCR3A) && defined(COM3A1)
		case  TIMER3A:  cbi(TCCR3A, COM3A1);    break;
     540:	80 91 90 00 	lds	r24, 0x0090	; 0x800090 <__TEXT_REGION_LENGTH__+0x700090>
     544:	8f 77       	andi	r24, 0x7F	; 127
     546:	07 c0       	rjmp	.+14     	; 0x556 <digitalWrite+0x96>
		#endif
		#if defined(TCCR3A) && defined(COM3B1)
		case  TIMER3B:  cbi(TCCR3A, COM3B1);    break;
     548:	80 91 90 00 	lds	r24, 0x0090	; 0x800090 <__TEXT_REGION_LENGTH__+0x700090>
     54c:	8f 7d       	andi	r24, 0xDF	; 223
     54e:	03 c0       	rjmp	.+6      	; 0x556 <digitalWrite+0x96>
		#endif
		#if defined(TCCR3A) && defined(COM3C1)
		case  TIMER3C:  cbi(TCCR3A, COM3C1);    break;
     550:	80 91 90 00 	lds	r24, 0x0090	; 0x800090 <__TEXT_REGION_LENGTH__+0x700090>
     554:	87 7f       	andi	r24, 0xF7	; 247
     556:	80 93 90 00 	sts	0x0090, r24	; 0x800090 <__TEXT_REGION_LENGTH__+0x700090>
     55a:	1b c0       	rjmp	.+54     	; 0x592 <digitalWrite+0xd2>
		#endif

		#if defined(TCCR4A) && defined(COM4A1)
		case  TIMER4A:  cbi(TCCR4A, COM4A1);    break;
     55c:	80 91 a0 00 	lds	r24, 0x00A0	; 0x8000a0 <__TEXT_REGION_LENGTH__+0x7000a0>
     560:	8f 77       	andi	r24, 0x7F	; 127
     562:	07 c0       	rjmp	.+14     	; 0x572 <digitalWrite+0xb2>
		#endif					
		#if defined(TCCR4A) && defined(COM4B1)
		case  TIMER4B:  cbi(TCCR4A, COM4B1);    break;
     564:	80 91 a0 00 	lds	r24, 0x00A0	; 0x8000a0 <__TEXT_REGION_LENGTH__+0x7000a0>
     568:	8f 7d       	andi	r24, 0xDF	; 223
     56a:	03 c0       	rjmp	.+6      	; 0x572 <digitalWrite+0xb2>
		#endif
		#if defined(TCCR4A) && defined(COM4C1)
		case  TIMER4C:  cbi(TCCR4A, COM4C1);    break;
     56c:	80 91 a0 00 	lds	r24, 0x00A0	; 0x8000a0 <__TEXT_REGION_LENGTH__+0x7000a0>
     570:	87 7f       	andi	r24, 0xF7	; 247
     572:	80 93 a0 00 	sts	0x00A0, r24	; 0x8000a0 <__TEXT_REGION_LENGTH__+0x7000a0>
     576:	0d c0       	rjmp	.+26     	; 0x592 <digitalWrite+0xd2>
		#if defined(TCCR4C) && defined(COM4D1)
		case TIMER4D:	cbi(TCCR4C, COM4D1);	break;
		#endif			
			
		#if defined(TCCR5A)
		case  TIMER5A:  cbi(TCCR5A, COM5A1);    break;
     578:	80 91 20 01 	lds	r24, 0x0120	; 0x800120 <__TEXT_REGION_LENGTH__+0x700120>
     57c:	8f 77       	andi	r24, 0x7F	; 127
     57e:	07 c0       	rjmp	.+14     	; 0x58e <digitalWrite+0xce>
		case  TIMER5B:  cbi(TCCR5A, COM5B1);    break;
     580:	80 91 20 01 	lds	r24, 0x0120	; 0x800120 <__TEXT_REGION_LENGTH__+0x700120>
     584:	8f 7d       	andi	r24, 0xDF	; 223
     586:	03 c0       	rjmp	.+6      	; 0x58e <digitalWrite+0xce>
		case  TIMER5C:  cbi(TCCR5A, COM5C1);    break;
     588:	80 91 20 01 	lds	r24, 0x0120	; 0x800120 <__TEXT_REGION_LENGTH__+0x700120>
     58c:	87 7f       	andi	r24, 0xF7	; 247
     58e:	80 93 20 01 	sts	0x0120, r24	; 0x800120 <__TEXT_REGION_LENGTH__+0x700120>

	// If the pin that support PWM output, we need to turn it off
	// before doing a digital write.
	if (timer != NOT_ON_TIMER) turnOffPWM(timer);

	out = portOutputRegister(port);
     592:	e9 2f       	mov	r30, r25
     594:	f0 e0       	ldi	r31, 0x00	; 0
     596:	ee 0f       	add	r30, r30
     598:	ff 1f       	adc	r31, r31
     59a:	e0 5b       	subi	r30, 0xB0	; 176
     59c:	fe 4f       	sbci	r31, 0xFE	; 254
     59e:	a5 91       	lpm	r26, Z+
     5a0:	b4 91       	lpm	r27, Z

	uint8_t oldSREG = SREG;
     5a2:	9f b7       	in	r25, 0x3f	; 63
	cli();
     5a4:	f8 94       	cli

	if (val == LOW) {
     5a6:	31 11       	cpse	r19, r1
     5a8:	04 c0       	rjmp	.+8      	; 0x5b2 <digitalWrite+0xf2>
		*out &= ~bit;
     5aa:	8c 91       	ld	r24, X
     5ac:	20 95       	com	r18
     5ae:	28 23       	and	r18, r24
     5b0:	02 c0       	rjmp	.+4      	; 0x5b6 <digitalWrite+0xf6>
	} else {
		*out |= bit;
     5b2:	ec 91       	ld	r30, X
     5b4:	2e 2b       	or	r18, r30
     5b6:	2c 93       	st	X, r18
	}

	SREG = oldSREG;
     5b8:	9f bf       	out	0x3f, r25	; 63
     5ba:	08 95       	ret

000005bc <micros>:
	return m;
}

unsigned long micros() {
	unsigned long m;
	uint8_t oldSREG = SREG, t;
     5bc:	3f b7       	in	r19, 0x3f	; 63
	
	cli();
     5be:	f8 94       	cli
	m = timer0_overflow_count;
     5c0:	80 91 74 02 	lds	r24, 0x0274	; 0x800274 <timer0_overflow_count>
     5c4:	90 91 75 02 	lds	r25, 0x0275	; 0x800275 <timer0_overflow_count+0x1>
     5c8:	a0 91 76 02 	lds	r26, 0x0276	; 0x800276 <timer0_overflow_count+0x2>
     5cc:	b0 91 77 02 	lds	r27, 0x0277	; 0x800277 <timer0_overflow_count+0x3>
#if defined(TCNT0)
	t = TCNT0;
     5d0:	26 b5       	in	r18, 0x26	; 38
#else
	#error TIMER 0 not defined
#endif

#ifdef TIFR0
	if ((TIFR0 & _BV(TOV0)) && (t < 255))
     5d2:	a8 9b       	sbis	0x15, 0	; 21
     5d4:	05 c0       	rjmp	.+10     	; 0x5e0 <micros+0x24>
     5d6:	2f 3f       	cpi	r18, 0xFF	; 255
     5d8:	19 f0       	breq	.+6      	; 0x5e0 <micros+0x24>
		m++;
     5da:	01 96       	adiw	r24, 0x01	; 1
     5dc:	a1 1d       	adc	r26, r1
     5de:	b1 1d       	adc	r27, r1
#else
	if ((TIFR & _BV(TOV0)) && (t < 255))
		m++;
#endif

	SREG = oldSREG;
     5e0:	3f bf       	out	0x3f, r19	; 63
	
	return ((m << 8) + t) * (64 / clockCyclesPerMicrosecond());
     5e2:	ba 2f       	mov	r27, r26
     5e4:	a9 2f       	mov	r26, r25
     5e6:	98 2f       	mov	r25, r24
     5e8:	88 27       	eor	r24, r24
     5ea:	82 0f       	add	r24, r18
     5ec:	91 1d       	adc	r25, r1
     5ee:	a1 1d       	adc	r26, r1
     5f0:	b1 1d       	adc	r27, r1
     5f2:	bc 01       	movw	r22, r24
     5f4:	cd 01       	movw	r24, r26
     5f6:	42 e0       	ldi	r20, 0x02	; 2
     5f8:	66 0f       	add	r22, r22
     5fa:	77 1f       	adc	r23, r23
     5fc:	88 1f       	adc	r24, r24
     5fe:	99 1f       	adc	r25, r25
     600:	4a 95       	dec	r20
     602:	d1 f7       	brne	.-12     	; 0x5f8 <micros+0x3c>
}
     604:	08 95       	ret

00000606 <_ZN5Servo5writeEi>:
    finISR(timer);
  }
}

void Servo::write(int value)
{
     606:	cf 92       	push	r12
     608:	df 92       	push	r13
     60a:	ef 92       	push	r14
     60c:	ff 92       	push	r15
     60e:	cf 93       	push	r28
     610:	df 93       	push	r29
     612:	ec 01       	movw	r28, r24
  if(value < MIN_PULSE_WIDTH)
     614:	60 32       	cpi	r22, 0x20	; 32
     616:	82 e0       	ldi	r24, 0x02	; 2
     618:	78 07       	cpc	r23, r24
     61a:	0c f0       	brlt	.+2      	; 0x61e <_ZN5Servo5writeEi+0x18>
     61c:	3d c0       	rjmp	.+122    	; 0x698 <_ZN5Servo5writeEi+0x92>
  {  // treat values less than 544 as angles in degrees (valid values in microseconds are handled as microseconds)
    if(value < 0) value = 0;
     61e:	77 fd       	sbrc	r23, 7
     620:	06 c0       	rjmp	.+12     	; 0x62e <_ZN5Servo5writeEi+0x28>
    if(value > 180) value = 180;
     622:	65 3b       	cpi	r22, 0xB5	; 181
     624:	71 05       	cpc	r23, r1
     626:	2c f0       	brlt	.+10     	; 0x632 <_ZN5Servo5writeEi+0x2c>
     628:	64 eb       	ldi	r22, 0xB4	; 180
     62a:	70 e0       	ldi	r23, 0x00	; 0
     62c:	02 c0       	rjmp	.+4      	; 0x632 <_ZN5Servo5writeEi+0x2c>

void Servo::write(int value)
{
  if(value < MIN_PULSE_WIDTH)
  {  // treat values less than 544 as angles in degrees (valid values in microseconds are handled as microseconds)
    if(value < 0) value = 0;
     62e:	60 e0       	ldi	r22, 0x00	; 0
     630:	70 e0       	ldi	r23, 0x00	; 0
    if(value > 180) value = 180;
    value = map(value, 0, 180, SERVO_MIN(),  SERVO_MAX());
     632:	89 81       	ldd	r24, Y+1	; 0x01
     634:	28 e8       	ldi	r18, 0x88	; 136
     636:	30 e0       	ldi	r19, 0x00	; 0
     638:	69 01       	movw	r12, r18
     63a:	c8 1a       	sub	r12, r24
     63c:	d1 08       	sbc	r13, r1
     63e:	87 fd       	sbrc	r24, 7
     640:	d3 94       	inc	r13
     642:	cc 0c       	add	r12, r12
     644:	dd 1c       	adc	r13, r13
     646:	cc 0c       	add	r12, r12
     648:	dd 1c       	adc	r13, r13
     64a:	0d 2c       	mov	r0, r13
     64c:	00 0c       	add	r0, r0
     64e:	ee 08       	sbc	r14, r14
     650:	ff 08       	sbc	r15, r15
  return random(diff) + howsmall;
}

long map(long x, long in_min, long in_max, long out_min, long out_max)
{
  return (x - in_min) * (out_max - out_min) / (in_max - in_min) + out_min;
     652:	8a 81       	ldd	r24, Y+2	; 0x02
     654:	28 e5       	ldi	r18, 0x58	; 88
     656:	32 e0       	ldi	r19, 0x02	; 2
     658:	28 1b       	sub	r18, r24
     65a:	31 09       	sbc	r19, r1
     65c:	87 fd       	sbrc	r24, 7
     65e:	33 95       	inc	r19
     660:	22 0f       	add	r18, r18
     662:	33 1f       	adc	r19, r19
     664:	22 0f       	add	r18, r18
     666:	33 1f       	adc	r19, r19
     668:	c9 01       	movw	r24, r18
     66a:	33 0f       	add	r19, r19
     66c:	aa 0b       	sbc	r26, r26
     66e:	bb 0b       	sbc	r27, r27
     670:	9c 01       	movw	r18, r24
     672:	ad 01       	movw	r20, r26
     674:	2c 19       	sub	r18, r12
     676:	3d 09       	sbc	r19, r13
     678:	4e 09       	sbc	r20, r14
     67a:	5f 09       	sbc	r21, r15
     67c:	db 01       	movw	r26, r22
     67e:	0e 94 d8 0c 	call	0x19b0	; 0x19b0 <__mulshisi3>
     682:	24 eb       	ldi	r18, 0xB4	; 180
     684:	30 e0       	ldi	r19, 0x00	; 0
     686:	40 e0       	ldi	r20, 0x00	; 0
     688:	50 e0       	ldi	r21, 0x00	; 0
     68a:	0e 94 b2 0c 	call	0x1964	; 0x1964 <__divmodsi4>
     68e:	c2 0e       	add	r12, r18
     690:	d3 1e       	adc	r13, r19
     692:	e4 1e       	adc	r14, r20
     694:	f5 1e       	adc	r15, r21
     696:	b6 01       	movw	r22, r12
}

void Servo::writeMicroseconds(int value)
{
  // calculate and store the values for the given channel
  byte channel = this->servoIndex;
     698:	38 81       	ld	r19, Y
  if( (channel < MAX_SERVOS) )   // ensure channel is valid
     69a:	30 33       	cpi	r19, 0x30	; 48
     69c:	80 f5       	brcc	.+96     	; 0x6fe <_ZN5Servo5writeEi+0xf8>
  {
    if( value < SERVO_MIN() )          // ensure pulse width is valid
     69e:	29 81       	ldd	r18, Y+1	; 0x01
     6a0:	88 e8       	ldi	r24, 0x88	; 136
     6a2:	90 e0       	ldi	r25, 0x00	; 0
     6a4:	82 1b       	sub	r24, r18
     6a6:	91 09       	sbc	r25, r1
     6a8:	27 fd       	sbrc	r18, 7
     6aa:	93 95       	inc	r25
     6ac:	88 0f       	add	r24, r24
     6ae:	99 1f       	adc	r25, r25
     6b0:	88 0f       	add	r24, r24
     6b2:	99 1f       	adc	r25, r25
     6b4:	68 17       	cp	r22, r24
     6b6:	79 07       	cpc	r23, r25
     6b8:	84 f0       	brlt	.+32     	; 0x6da <_ZN5Servo5writeEi+0xd4>
      value = SERVO_MIN();
    else if( value > SERVO_MAX() )
     6ba:	8a 81       	ldd	r24, Y+2	; 0x02
     6bc:	48 e5       	ldi	r20, 0x58	; 88
     6be:	52 e0       	ldi	r21, 0x02	; 2
     6c0:	48 1b       	sub	r20, r24
     6c2:	51 09       	sbc	r21, r1
     6c4:	87 fd       	sbrc	r24, 7
     6c6:	53 95       	inc	r21
     6c8:	44 0f       	add	r20, r20
     6ca:	55 1f       	adc	r21, r21
     6cc:	44 0f       	add	r20, r20
     6ce:	55 1f       	adc	r21, r21
     6d0:	cb 01       	movw	r24, r22
     6d2:	46 17       	cp	r20, r22
     6d4:	57 07       	cpc	r21, r23
     6d6:	0c f4       	brge	.+2      	; 0x6da <_ZN5Servo5writeEi+0xd4>
     6d8:	ca 01       	movw	r24, r20
      value = SERVO_MAX();

    value = value - TRIM_DURATION;
    value = usToTicks(value);  // convert to ticks after compensating for interrupt overhead - 12 Aug 2009
     6da:	02 97       	sbiw	r24, 0x02	; 2
     6dc:	88 0f       	add	r24, r24
     6de:	99 1f       	adc	r25, r25

    uint8_t oldSREG = SREG;
     6e0:	4f b7       	in	r20, 0x3f	; 63
    cli();
     6e2:	f8 94       	cli
    servos[channel].ticks = value;
     6e4:	23 2f       	mov	r18, r19
     6e6:	30 e0       	ldi	r19, 0x00	; 0
     6e8:	f9 01       	movw	r30, r18
     6ea:	ee 0f       	add	r30, r30
     6ec:	ff 1f       	adc	r31, r31
     6ee:	2e 0f       	add	r18, r30
     6f0:	3f 1f       	adc	r19, r31
     6f2:	f9 01       	movw	r30, r18
     6f4:	e0 56       	subi	r30, 0x60	; 96
     6f6:	fc 4f       	sbci	r31, 0xFC	; 252
     6f8:	92 83       	std	Z+2, r25	; 0x02
     6fa:	81 83       	std	Z+1, r24	; 0x01
    SREG = oldSREG;
     6fc:	4f bf       	out	0x3f, r20	; 63
    if(value < 0) value = 0;
    if(value > 180) value = 180;
    value = map(value, 0, 180, SERVO_MIN(),  SERVO_MAX());
  }
  this->writeMicroseconds(value);
}
     6fe:	df 91       	pop	r29
     700:	cf 91       	pop	r28
     702:	ff 90       	pop	r15
     704:	ef 90       	pop	r14
     706:	df 90       	pop	r13
     708:	cf 90       	pop	r12
     70a:	08 95       	ret

0000070c <_ZN5Servo6attachEi>:
  else
    this->servoIndex = INVALID_SERVO ;  // too many servos
}

uint8_t Servo::attach(int pin)
{
     70c:	cf 93       	push	r28
     70e:	df 93       	push	r29
     710:	dc 01       	movw	r26, r24
  return this->attach(pin, MIN_PULSE_WIDTH, MAX_PULSE_WIDTH);
}

uint8_t Servo::attach(int pin, int min, int max)
{
  if(this->servoIndex < MAX_SERVOS ) {
     712:	8c 91       	ld	r24, X
     714:	80 33       	cpi	r24, 0x30	; 48
     716:	08 f0       	brcs	.+2      	; 0x71a <_ZN5Servo6attachEi+0xe>
     718:	6d c0       	rjmp	.+218    	; 0x7f4 <_ZN5Servo6attachEi+0xe8>
#include "wiring_private.h"
#include "pins_arduino.h"

void pinMode(uint8_t pin, uint8_t mode)
{
	uint8_t bit = digitalPinToBitMask(pin);
     71a:	cb 01       	movw	r24, r22
     71c:	99 27       	eor	r25, r25
     71e:	fc 01       	movw	r30, r24
     720:	e0 55       	subi	r30, 0x50	; 80
     722:	fe 4f       	sbci	r31, 0xFE	; 254
     724:	24 91       	lpm	r18, Z
	uint8_t port = digitalPinToPort(pin);
     726:	fc 01       	movw	r30, r24
     728:	e6 59       	subi	r30, 0x96	; 150
     72a:	fe 4f       	sbci	r31, 0xFE	; 254
     72c:	84 91       	lpm	r24, Z
	volatile uint8_t *reg, *out;

	if (port == NOT_A_PIN) return;
     72e:	88 23       	and	r24, r24
     730:	99 f0       	breq	.+38     	; 0x758 <_ZN5Servo6attachEi+0x4c>

	// JWS: can I let the optimizer do this?
	reg = portModeRegister(port);
     732:	90 e0       	ldi	r25, 0x00	; 0
     734:	88 0f       	add	r24, r24
     736:	99 1f       	adc	r25, r25
     738:	fc 01       	movw	r30, r24
     73a:	ea 5c       	subi	r30, 0xCA	; 202
     73c:	fe 4f       	sbci	r31, 0xFE	; 254
     73e:	c5 91       	lpm	r28, Z+
     740:	d4 91       	lpm	r29, Z
	out = portOutputRegister(port);
     742:	fc 01       	movw	r30, r24
     744:	e0 5b       	subi	r30, 0xB0	; 176
     746:	fe 4f       	sbci	r31, 0xFE	; 254
     748:	85 91       	lpm	r24, Z+
     74a:	94 91       	lpm	r25, Z
                cli();
		*reg &= ~bit;
		*out |= bit;
		SREG = oldSREG;
	} else {
		uint8_t oldSREG = SREG;
     74c:	8f b7       	in	r24, 0x3f	; 63
                cli();
     74e:	f8 94       	cli
		*reg |= bit;
     750:	e8 81       	ld	r30, Y
     752:	e2 2b       	or	r30, r18
     754:	e8 83       	st	Y, r30
		SREG = oldSREG;
     756:	8f bf       	out	0x3f, r24	; 63
    pinMode( pin, OUTPUT) ;                                   // set servo pin to output
    servos[this->servoIndex].Pin.nbr = pin;
     758:	8c 91       	ld	r24, X
     75a:	e8 2f       	mov	r30, r24
     75c:	f0 e0       	ldi	r31, 0x00	; 0
     75e:	9f 01       	movw	r18, r30
     760:	22 0f       	add	r18, r18
     762:	33 1f       	adc	r19, r19
     764:	e2 0f       	add	r30, r18
     766:	f3 1f       	adc	r31, r19
     768:	e0 56       	subi	r30, 0x60	; 96
     76a:	fc 4f       	sbci	r31, 0xFC	; 252
     76c:	6f 73       	andi	r22, 0x3F	; 63
     76e:	90 81       	ld	r25, Z
     770:	90 7c       	andi	r25, 0xC0	; 192
     772:	69 2b       	or	r22, r25
     774:	60 83       	st	Z, r22
    // todo min/max check: abs(min - MIN_PULSE_WIDTH) /4 < 128
    this->min  = (MIN_PULSE_WIDTH - min)/4; //resolution of min/max is 4 uS
     776:	11 96       	adiw	r26, 0x01	; 1
     778:	1c 92       	st	X, r1
     77a:	11 97       	sbiw	r26, 0x01	; 1
    this->max  = (MAX_PULSE_WIDTH - max)/4;
     77c:	12 96       	adiw	r26, 0x02	; 2
     77e:	1c 92       	st	X, r1
     780:	12 97       	sbiw	r26, 0x02	; 2
    // initialize the timer if it has not already been initialized
    timer16_Sequence_t timer = SERVO_INDEX_TO_TIMER(servoIndex);
     782:	6c e0       	ldi	r22, 0x0C	; 12
     784:	0e 94 e2 0f 	call	0x1fc4	; 0x1fc4 <__udivmodqi4>

static boolean isTimerActive(timer16_Sequence_t timer)
{
  // returns true if any servo is active on this timer
  for(uint8_t channel=0; channel < SERVOS_PER_TIMER; channel++) {
    if(SERVO(timer,channel).Pin.isActive == true)
     788:	9c e0       	ldi	r25, 0x0C	; 12
     78a:	89 9f       	mul	r24, r25
     78c:	b0 01       	movw	r22, r0
     78e:	11 24       	eor	r1, r1
     790:	40 e0       	ldi	r20, 0x00	; 0
     792:	50 e0       	ldi	r21, 0x00	; 0
     794:	9b 01       	movw	r18, r22
     796:	24 0f       	add	r18, r20
     798:	35 1f       	adc	r19, r21
     79a:	f9 01       	movw	r30, r18
     79c:	ee 0f       	add	r30, r30
     79e:	ff 1f       	adc	r31, r31
     7a0:	2e 0f       	add	r18, r30
     7a2:	3f 1f       	adc	r19, r31
     7a4:	f9 01       	movw	r30, r18
     7a6:	e0 56       	subi	r30, 0x60	; 96
     7a8:	fc 4f       	sbci	r31, 0xFC	; 252
     7aa:	90 81       	ld	r25, Z
     7ac:	96 fd       	sbrc	r25, 6
     7ae:	16 c0       	rjmp	.+44     	; 0x7dc <_ZN5Servo6attachEi+0xd0>
     7b0:	4f 5f       	subi	r20, 0xFF	; 255
     7b2:	5f 4f       	sbci	r21, 0xFF	; 255
}

static boolean isTimerActive(timer16_Sequence_t timer)
{
  // returns true if any servo is active on this timer
  for(uint8_t channel=0; channel < SERVOS_PER_TIMER; channel++) {
     7b4:	4c 30       	cpi	r20, 0x0C	; 12
     7b6:	51 05       	cpc	r21, r1
     7b8:	69 f7       	brne	.-38     	; 0x794 <_ZN5Servo6attachEi+0x88>


static void initISR(timer16_Sequence_t timer)
{
#if defined (_useTimer1)
  if(timer == _timer1) {
     7ba:	81 30       	cpi	r24, 0x01	; 1
     7bc:	f9 f4       	brne	.+62     	; 0x7fc <_ZN5Servo6attachEi+0xf0>
    TCCR1A = 0;             // normal counting mode
     7be:	10 92 80 00 	sts	0x0080, r1	; 0x800080 <__TEXT_REGION_LENGTH__+0x700080>
    TCCR1B = _BV(CS11);     // set prescaler of 8
     7c2:	82 e0       	ldi	r24, 0x02	; 2
     7c4:	80 93 81 00 	sts	0x0081, r24	; 0x800081 <__TEXT_REGION_LENGTH__+0x700081>
    TCNT1 = 0;              // clear the timer count
     7c8:	10 92 85 00 	sts	0x0085, r1	; 0x800085 <__TEXT_REGION_LENGTH__+0x700085>
     7cc:	10 92 84 00 	sts	0x0084, r1	; 0x800084 <__TEXT_REGION_LENGTH__+0x700084>
#if defined(__AVR_ATmega8__)|| defined(__AVR_ATmega128__)
    TIFR |= _BV(OCF1A);      // clear any pending interrupts;
    TIMSK |=  _BV(OCIE1A) ;  // enable the output compare interrupt
#else
    // here if not ATmega8 or ATmega128
    TIFR1 |= _BV(OCF1A);     // clear any pending interrupts;
     7d0:	b1 9a       	sbi	0x16, 1	; 22
    TIMSK1 |=  _BV(OCIE1A) ; // enable the output compare interrupt
     7d2:	80 91 6f 00 	lds	r24, 0x006F	; 0x80006f <__TEXT_REGION_LENGTH__+0x70006f>
     7d6:	82 60       	ori	r24, 0x02	; 2
     7d8:	80 93 6f 00 	sts	0x006F, r24	; 0x80006f <__TEXT_REGION_LENGTH__+0x70006f>
    this->max  = (MAX_PULSE_WIDTH - max)/4;
    // initialize the timer if it has not already been initialized
    timer16_Sequence_t timer = SERVO_INDEX_TO_TIMER(servoIndex);
    if(isTimerActive(timer) == false)
      initISR(timer);
    servos[this->servoIndex].Pin.isActive = true;  // this must be set after the check for isTimerActive
     7dc:	ec 91       	ld	r30, X
     7de:	f0 e0       	ldi	r31, 0x00	; 0
     7e0:	cf 01       	movw	r24, r30
     7e2:	88 0f       	add	r24, r24
     7e4:	99 1f       	adc	r25, r25
     7e6:	e8 0f       	add	r30, r24
     7e8:	f9 1f       	adc	r31, r25
     7ea:	e0 56       	subi	r30, 0x60	; 96
     7ec:	fc 4f       	sbci	r31, 0xFC	; 252
     7ee:	80 81       	ld	r24, Z
     7f0:	80 64       	ori	r24, 0x40	; 64
     7f2:	80 83       	st	Z, r24
    this->servoIndex = INVALID_SERVO ;  // too many servos
}

uint8_t Servo::attach(int pin)
{
  return this->attach(pin, MIN_PULSE_WIDTH, MAX_PULSE_WIDTH);
     7f4:	8c 91       	ld	r24, X
}
     7f6:	df 91       	pop	r29
     7f8:	cf 91       	pop	r28
     7fa:	08 95       	ret
#endif
  }
#endif

#if defined (_useTimer3)
  if(timer == _timer3) {
     7fc:	82 30       	cpi	r24, 0x02	; 2
     7fe:	61 f4       	brne	.+24     	; 0x818 <_ZN5Servo6attachEi+0x10c>
    TCCR3A = 0;             // normal counting mode
     800:	10 92 90 00 	sts	0x0090, r1	; 0x800090 <__TEXT_REGION_LENGTH__+0x700090>
    TCCR3B = _BV(CS31);     // set prescaler of 8
     804:	80 93 91 00 	sts	0x0091, r24	; 0x800091 <__TEXT_REGION_LENGTH__+0x700091>
    TCNT3 = 0;              // clear the timer count
     808:	10 92 95 00 	sts	0x0095, r1	; 0x800095 <__TEXT_REGION_LENGTH__+0x700095>
     80c:	10 92 94 00 	sts	0x0094, r1	; 0x800094 <__TEXT_REGION_LENGTH__+0x700094>
#if defined(__AVR_ATmega128__)
    TIFR |= _BV(OCF3A);     // clear any pending interrupts;
	ETIMSK |= _BV(OCIE3A);  // enable the output compare interrupt
#else
    TIFR3 = _BV(OCF3A);     // clear any pending interrupts;
     810:	88 bb       	out	0x18, r24	; 24
    TIMSK3 =  _BV(OCIE3A) ; // enable the output compare interrupt
     812:	80 93 71 00 	sts	0x0071, r24	; 0x800071 <__TEXT_REGION_LENGTH__+0x700071>
     816:	e2 cf       	rjmp	.-60     	; 0x7dc <_ZN5Servo6attachEi+0xd0>
#endif
  }
#endif

#if defined (_useTimer4)
  if(timer == _timer4) {
     818:	83 30       	cpi	r24, 0x03	; 3
     81a:	69 f4       	brne	.+26     	; 0x836 <_ZN5Servo6attachEi+0x12a>
    TCCR4A = 0;             // normal counting mode
     81c:	10 92 a0 00 	sts	0x00A0, r1	; 0x8000a0 <__TEXT_REGION_LENGTH__+0x7000a0>
    TCCR4B = _BV(CS41);     // set prescaler of 8
     820:	82 e0       	ldi	r24, 0x02	; 2
     822:	80 93 a1 00 	sts	0x00A1, r24	; 0x8000a1 <__TEXT_REGION_LENGTH__+0x7000a1>
    TCNT4 = 0;              // clear the timer count
     826:	10 92 a5 00 	sts	0x00A5, r1	; 0x8000a5 <__TEXT_REGION_LENGTH__+0x7000a5>
     82a:	10 92 a4 00 	sts	0x00A4, r1	; 0x8000a4 <__TEXT_REGION_LENGTH__+0x7000a4>
    TIFR4 = _BV(OCF4A);     // clear any pending interrupts;
     82e:	89 bb       	out	0x19, r24	; 25
    TIMSK4 =  _BV(OCIE4A) ; // enable the output compare interrupt
     830:	80 93 72 00 	sts	0x0072, r24	; 0x800072 <__TEXT_REGION_LENGTH__+0x700072>
     834:	d3 cf       	rjmp	.-90     	; 0x7dc <_ZN5Servo6attachEi+0xd0>
  }
#endif

#if defined (_useTimer5)
  if(timer == _timer5) {
     836:	81 11       	cpse	r24, r1
     838:	d1 cf       	rjmp	.-94     	; 0x7dc <_ZN5Servo6attachEi+0xd0>
    TCCR5A = 0;             // normal counting mode
     83a:	10 92 20 01 	sts	0x0120, r1	; 0x800120 <__TEXT_REGION_LENGTH__+0x700120>
    TCCR5B = _BV(CS51);     // set prescaler of 8
     83e:	82 e0       	ldi	r24, 0x02	; 2
     840:	80 93 21 01 	sts	0x0121, r24	; 0x800121 <__TEXT_REGION_LENGTH__+0x700121>
    TCNT5 = 0;              // clear the timer count
     844:	10 92 25 01 	sts	0x0125, r1	; 0x800125 <__TEXT_REGION_LENGTH__+0x700125>
     848:	10 92 24 01 	sts	0x0124, r1	; 0x800124 <__TEXT_REGION_LENGTH__+0x700124>
    TIFR5 = _BV(OCF5A);     // clear any pending interrupts;
     84c:	8a bb       	out	0x1a, r24	; 26
    TIMSK5 =  _BV(OCIE5A) ; // enable the output compare interrupt
     84e:	80 93 73 00 	sts	0x0073, r24	; 0x800073 <__TEXT_REGION_LENGTH__+0x700073>
     852:	c4 cf       	rjmp	.-120    	; 0x7dc <_ZN5Servo6attachEi+0xd0>

00000854 <_ZL17handle_interrupts18timer16_Sequence_tPVjS1_>:
#define SERVO_MAX() (MAX_PULSE_WIDTH - this->max * 4)  // maximum value in uS for this servo

/************ static functions common to all instances ***********************/

static inline void handle_interrupts(timer16_Sequence_t timer, volatile uint16_t *TCNTn, volatile uint16_t* OCRnA)
{
     854:	cf 92       	push	r12
     856:	df 92       	push	r13
     858:	ef 92       	push	r14
     85a:	ff 92       	push	r15
     85c:	0f 93       	push	r16
     85e:	1f 93       	push	r17
     860:	cf 93       	push	r28
     862:	df 93       	push	r29
     864:	6c 01       	movw	r12, r24
     866:	8b 01       	movw	r16, r22
     868:	7a 01       	movw	r14, r20
  if( Channel[timer] < 0 )
     86a:	ec 01       	movw	r28, r24
     86c:	c1 59       	subi	r28, 0x91	; 145
     86e:	dd 4f       	sbci	r29, 0xFD	; 253
     870:	88 81       	ld	r24, Y
     872:	87 ff       	sbrs	r24, 7
     874:	04 c0       	rjmp	.+8      	; 0x87e <_ZL17handle_interrupts18timer16_Sequence_tPVjS1_+0x2a>
    *TCNTn = 0; // channel set to -1 indicated that refresh interval completed so reset the timer
     876:	fb 01       	movw	r30, r22
     878:	11 82       	std	Z+1, r1	; 0x01
     87a:	10 82       	st	Z, r1
     87c:	24 c0       	rjmp	.+72     	; 0x8c6 <_ZL17handle_interrupts18timer16_Sequence_tPVjS1_+0x72>
  else{
    if( SERVO_INDEX(timer,Channel[timer]) < ServoCount && SERVO(timer,Channel[timer]).Pin.isActive == true )
     87e:	2c e0       	ldi	r18, 0x0C	; 12
     880:	2c 9d       	mul	r18, r12
     882:	c0 01       	movw	r24, r0
     884:	2d 9d       	mul	r18, r13
     886:	90 0d       	add	r25, r0
     888:	11 24       	eor	r1, r1
     88a:	28 81       	ld	r18, Y
     88c:	ac 01       	movw	r20, r24
     88e:	42 0f       	add	r20, r18
     890:	51 1d       	adc	r21, r1
     892:	27 fd       	sbrc	r18, 7
     894:	5a 95       	dec	r21
     896:	20 91 30 04 	lds	r18, 0x0430	; 0x800430 <ServoCount>
     89a:	30 e0       	ldi	r19, 0x00	; 0
     89c:	42 17       	cp	r20, r18
     89e:	53 07       	cpc	r21, r19
     8a0:	94 f4       	brge	.+36     	; 0x8c6 <_ZL17handle_interrupts18timer16_Sequence_tPVjS1_+0x72>
     8a2:	28 81       	ld	r18, Y
     8a4:	ac 01       	movw	r20, r24
     8a6:	42 0f       	add	r20, r18
     8a8:	51 1d       	adc	r21, r1
     8aa:	27 fd       	sbrc	r18, 7
     8ac:	5a 95       	dec	r21
     8ae:	9a 01       	movw	r18, r20
     8b0:	fa 01       	movw	r30, r20
     8b2:	ee 0f       	add	r30, r30
     8b4:	ff 1f       	adc	r31, r31
     8b6:	2e 0f       	add	r18, r30
     8b8:	3f 1f       	adc	r19, r31
     8ba:	f9 01       	movw	r30, r18
     8bc:	e0 56       	subi	r30, 0x60	; 96
     8be:	fc 4f       	sbci	r31, 0xFC	; 252
     8c0:	20 81       	ld	r18, Z
     8c2:	26 fd       	sbrc	r18, 6
     8c4:	19 c0       	rjmp	.+50     	; 0x8f8 <_ZL17handle_interrupts18timer16_Sequence_tPVjS1_+0xa4>
      digitalWrite( SERVO(timer,Channel[timer]).Pin.nbr,LOW); // pulse this channel low if activated
  }

  Channel[timer]++;    // increment to the next channel
     8c6:	88 81       	ld	r24, Y
     8c8:	8f 5f       	subi	r24, 0xFF	; 255
     8ca:	88 83       	st	Y, r24
  if( SERVO_INDEX(timer,Channel[timer]) < ServoCount && Channel[timer] < SERVOS_PER_TIMER) {
     8cc:	2c e0       	ldi	r18, 0x0C	; 12
     8ce:	2c 9d       	mul	r18, r12
     8d0:	c0 01       	movw	r24, r0
     8d2:	2d 9d       	mul	r18, r13
     8d4:	90 0d       	add	r25, r0
     8d6:	11 24       	eor	r1, r1
     8d8:	28 81       	ld	r18, Y
     8da:	ac 01       	movw	r20, r24
     8dc:	42 0f       	add	r20, r18
     8de:	51 1d       	adc	r21, r1
     8e0:	27 fd       	sbrc	r18, 7
     8e2:	5a 95       	dec	r21
     8e4:	20 91 30 04 	lds	r18, 0x0430	; 0x800430 <ServoCount>
     8e8:	30 e0       	ldi	r19, 0x00	; 0
     8ea:	42 17       	cp	r20, r18
     8ec:	53 07       	cpc	r21, r19
     8ee:	b4 f4       	brge	.+44     	; 0x91c <_ZL17handle_interrupts18timer16_Sequence_tPVjS1_+0xc8>
     8f0:	28 81       	ld	r18, Y
     8f2:	2c 30       	cpi	r18, 0x0C	; 12
     8f4:	3c f1       	brlt	.+78     	; 0x944 <_ZL17handle_interrupts18timer16_Sequence_tPVjS1_+0xf0>
     8f6:	12 c0       	rjmp	.+36     	; 0x91c <_ZL17handle_interrupts18timer16_Sequence_tPVjS1_+0xc8>
{
  if( Channel[timer] < 0 )
    *TCNTn = 0; // channel set to -1 indicated that refresh interval completed so reset the timer
  else{
    if( SERVO_INDEX(timer,Channel[timer]) < ServoCount && SERVO(timer,Channel[timer]).Pin.isActive == true )
      digitalWrite( SERVO(timer,Channel[timer]).Pin.nbr,LOW); // pulse this channel low if activated
     8f8:	28 81       	ld	r18, Y
     8fa:	82 0f       	add	r24, r18
     8fc:	91 1d       	adc	r25, r1
     8fe:	27 fd       	sbrc	r18, 7
     900:	9a 95       	dec	r25
     902:	fc 01       	movw	r30, r24
     904:	ee 0f       	add	r30, r30
     906:	ff 1f       	adc	r31, r31
     908:	8e 0f       	add	r24, r30
     90a:	9f 1f       	adc	r25, r31
     90c:	fc 01       	movw	r30, r24
     90e:	e0 56       	subi	r30, 0x60	; 96
     910:	fc 4f       	sbci	r31, 0xFC	; 252
     912:	80 81       	ld	r24, Z
     914:	60 e0       	ldi	r22, 0x00	; 0
     916:	8f 73       	andi	r24, 0x3F	; 63
     918:	d3 dd       	rcall	.-1114   	; 0x4c0 <digitalWrite>
     91a:	d5 cf       	rjmp	.-86     	; 0x8c6 <_ZL17handle_interrupts18timer16_Sequence_tPVjS1_+0x72>
    if(SERVO(timer,Channel[timer]).Pin.isActive == true)     // check if activated
      digitalWrite( SERVO(timer,Channel[timer]).Pin.nbr,HIGH); // its an active channel so pulse it high
  }
  else {
    // finished all channels so wait for the refresh period to expire before starting over
    if( ((unsigned)*TCNTn) + 4 < usToTicks(REFRESH_INTERVAL) )  // allow a few ticks to ensure the next OCR1A not missed
     91c:	f8 01       	movw	r30, r16
     91e:	80 81       	ld	r24, Z
     920:	91 81       	ldd	r25, Z+1	; 0x01
     922:	04 96       	adiw	r24, 0x04	; 4
     924:	80 34       	cpi	r24, 0x40	; 64
     926:	9c 49       	sbci	r25, 0x9C	; 156
     928:	18 f4       	brcc	.+6      	; 0x930 <_ZL17handle_interrupts18timer16_Sequence_tPVjS1_+0xdc>
      *OCRnA = (unsigned int)usToTicks(REFRESH_INTERVAL);
     92a:	80 e4       	ldi	r24, 0x40	; 64
     92c:	9c e9       	ldi	r25, 0x9C	; 156
     92e:	04 c0       	rjmp	.+8      	; 0x938 <_ZL17handle_interrupts18timer16_Sequence_tPVjS1_+0xe4>
    else
      *OCRnA = *TCNTn + 4;  // at least REFRESH_INTERVAL has elapsed
     930:	f8 01       	movw	r30, r16
     932:	80 81       	ld	r24, Z
     934:	91 81       	ldd	r25, Z+1	; 0x01
     936:	04 96       	adiw	r24, 0x04	; 4
     938:	f7 01       	movw	r30, r14
     93a:	91 83       	std	Z+1, r25	; 0x01
     93c:	80 83       	st	Z, r24
    Channel[timer] = -1; // this will get incremented at the end of the refresh period to start again at the first channel
     93e:	8f ef       	ldi	r24, 0xFF	; 255
     940:	88 83       	st	Y, r24
     942:	44 c0       	rjmp	.+136    	; 0x9cc <_ZL17handle_interrupts18timer16_Sequence_tPVjS1_+0x178>
      digitalWrite( SERVO(timer,Channel[timer]).Pin.nbr,LOW); // pulse this channel low if activated
  }

  Channel[timer]++;    // increment to the next channel
  if( SERVO_INDEX(timer,Channel[timer]) < ServoCount && Channel[timer] < SERVOS_PER_TIMER) {
    *OCRnA = *TCNTn + SERVO(timer,Channel[timer]).ticks;
     944:	f8 01       	movw	r30, r16
     946:	40 81       	ld	r20, Z
     948:	51 81       	ldd	r21, Z+1	; 0x01
     94a:	28 81       	ld	r18, Y
     94c:	bc 01       	movw	r22, r24
     94e:	62 0f       	add	r22, r18
     950:	71 1d       	adc	r23, r1
     952:	27 fd       	sbrc	r18, 7
     954:	7a 95       	dec	r23
     956:	9b 01       	movw	r18, r22
     958:	fb 01       	movw	r30, r22
     95a:	ee 0f       	add	r30, r30
     95c:	ff 1f       	adc	r31, r31
     95e:	2e 0f       	add	r18, r30
     960:	3f 1f       	adc	r19, r31
     962:	f9 01       	movw	r30, r18
     964:	e0 56       	subi	r30, 0x60	; 96
     966:	fc 4f       	sbci	r31, 0xFC	; 252
     968:	21 81       	ldd	r18, Z+1	; 0x01
     96a:	32 81       	ldd	r19, Z+2	; 0x02
     96c:	24 0f       	add	r18, r20
     96e:	35 1f       	adc	r19, r21
     970:	f7 01       	movw	r30, r14
     972:	31 83       	std	Z+1, r19	; 0x01
     974:	20 83       	st	Z, r18
    if(SERVO(timer,Channel[timer]).Pin.isActive == true)     // check if activated
     976:	28 81       	ld	r18, Y
     978:	ac 01       	movw	r20, r24
     97a:	42 0f       	add	r20, r18
     97c:	51 1d       	adc	r21, r1
     97e:	27 fd       	sbrc	r18, 7
     980:	5a 95       	dec	r21
     982:	9a 01       	movw	r18, r20
     984:	fa 01       	movw	r30, r20
     986:	ee 0f       	add	r30, r30
     988:	ff 1f       	adc	r31, r31
     98a:	2e 0f       	add	r18, r30
     98c:	3f 1f       	adc	r19, r31
     98e:	f9 01       	movw	r30, r18
     990:	e0 56       	subi	r30, 0x60	; 96
     992:	fc 4f       	sbci	r31, 0xFC	; 252
     994:	20 81       	ld	r18, Z
     996:	26 ff       	sbrs	r18, 6
     998:	19 c0       	rjmp	.+50     	; 0x9cc <_ZL17handle_interrupts18timer16_Sequence_tPVjS1_+0x178>
      digitalWrite( SERVO(timer,Channel[timer]).Pin.nbr,HIGH); // its an active channel so pulse it high
     99a:	28 81       	ld	r18, Y
     99c:	82 0f       	add	r24, r18
     99e:	91 1d       	adc	r25, r1
     9a0:	27 fd       	sbrc	r18, 7
     9a2:	9a 95       	dec	r25
     9a4:	fc 01       	movw	r30, r24
     9a6:	ee 0f       	add	r30, r30
     9a8:	ff 1f       	adc	r31, r31
     9aa:	8e 0f       	add	r24, r30
     9ac:	9f 1f       	adc	r25, r31
     9ae:	fc 01       	movw	r30, r24
     9b0:	e0 56       	subi	r30, 0x60	; 96
     9b2:	fc 4f       	sbci	r31, 0xFC	; 252
     9b4:	80 81       	ld	r24, Z
     9b6:	61 e0       	ldi	r22, 0x01	; 1
     9b8:	8f 73       	andi	r24, 0x3F	; 63
      *OCRnA = (unsigned int)usToTicks(REFRESH_INTERVAL);
    else
      *OCRnA = *TCNTn + 4;  // at least REFRESH_INTERVAL has elapsed
    Channel[timer] = -1; // this will get incremented at the end of the refresh period to start again at the first channel
  }
}
     9ba:	df 91       	pop	r29
     9bc:	cf 91       	pop	r28
     9be:	1f 91       	pop	r17
     9c0:	0f 91       	pop	r16
     9c2:	ff 90       	pop	r15
     9c4:	ef 90       	pop	r14
     9c6:	df 90       	pop	r13

  Channel[timer]++;    // increment to the next channel
  if( SERVO_INDEX(timer,Channel[timer]) < ServoCount && Channel[timer] < SERVOS_PER_TIMER) {
    *OCRnA = *TCNTn + SERVO(timer,Channel[timer]).ticks;
    if(SERVO(timer,Channel[timer]).Pin.isActive == true)     // check if activated
      digitalWrite( SERVO(timer,Channel[timer]).Pin.nbr,HIGH); // its an active channel so pulse it high
     9c8:	cf 90       	pop	r12
     9ca:	7a cd       	rjmp	.-1292   	; 0x4c0 <digitalWrite>
      *OCRnA = (unsigned int)usToTicks(REFRESH_INTERVAL);
    else
      *OCRnA = *TCNTn + 4;  // at least REFRESH_INTERVAL has elapsed
    Channel[timer] = -1; // this will get incremented at the end of the refresh period to start again at the first channel
  }
}
     9cc:	df 91       	pop	r29
     9ce:	cf 91       	pop	r28
     9d0:	1f 91       	pop	r17
     9d2:	0f 91       	pop	r16
     9d4:	ff 90       	pop	r15
     9d6:	ef 90       	pop	r14
     9d8:	df 90       	pop	r13
     9da:	cf 90       	pop	r12
     9dc:	08 95       	ret

000009de <twi_stop>:
 * Output   none
 */
void twi_stop(void)
{
  // send stop condition
  TWCR = _BV(TWEN) | _BV(TWIE) | _BV(TWEA) | _BV(TWINT) | _BV(TWSTO);
     9de:	85 ed       	ldi	r24, 0xD5	; 213
     9e0:	80 93 bc 00 	sts	0x00BC, r24	; 0x8000bc <__TEXT_REGION_LENGTH__+0x7000bc>

  // wait for stop condition to be exectued on bus
  // TWINT is not set after a stop condition!
  while(TWCR & _BV(TWSTO)){
     9e4:	80 91 bc 00 	lds	r24, 0x00BC	; 0x8000bc <__TEXT_REGION_LENGTH__+0x7000bc>
     9e8:	84 fd       	sbrc	r24, 4
     9ea:	fc cf       	rjmp	.-8      	; 0x9e4 <twi_stop+0x6>
    continue;
  }

  // update twi state
  twi_state = TWI_READY;
     9ec:	10 92 d2 02 	sts	0x02D2, r1	; 0x8002d2 <twi_state.lto_priv.50>
     9f0:	08 95       	ret

000009f2 <twi_transmit>:
uint8_t twi_transmit(const uint8_t* data, uint8_t length)
{
  uint8_t i;

  // ensure data will fit into buffer
  if(TWI_BUFFER_LENGTH < (twi_txBufferLength+length)){
     9f2:	40 91 4c 02 	lds	r20, 0x024C	; 0x80024c <twi_txBufferLength>
     9f6:	26 2f       	mov	r18, r22
     9f8:	30 e0       	ldi	r19, 0x00	; 0
     9fa:	24 0f       	add	r18, r20
     9fc:	31 1d       	adc	r19, r1
     9fe:	21 32       	cpi	r18, 0x21	; 33
     a00:	31 05       	cpc	r19, r1
     a02:	dc f4       	brge	.+54     	; 0xa3a <twi_transmit+0x48>
    return 1;
  }
  
  // ensure we are currently a slave transmitter
  if(TWI_STX != twi_state){
     a04:	20 91 d2 02 	lds	r18, 0x02D2	; 0x8002d2 <twi_state.lto_priv.50>
     a08:	24 30       	cpi	r18, 0x04	; 4
     a0a:	c9 f4       	brne	.+50     	; 0xa3e <twi_transmit+0x4c>
     a0c:	fc 01       	movw	r30, r24
     a0e:	80 e0       	ldi	r24, 0x00	; 0
     a10:	90 e0       	ldi	r25, 0x00	; 0
    return 2;
  }
  
  // set length and copy data into tx buffer
  for(i = 0; i < length; ++i){
     a12:	86 17       	cp	r24, r22
     a14:	58 f4       	brcc	.+22     	; 0xa2c <twi_transmit+0x3a>
    twi_txBuffer[twi_txBufferLength+i] = data[i];
     a16:	30 91 4c 02 	lds	r19, 0x024C	; 0x80024c <twi_txBufferLength>
     a1a:	21 91       	ld	r18, Z+
     a1c:	dc 01       	movw	r26, r24
     a1e:	a4 5d       	subi	r26, 0xD4	; 212
     a20:	bd 4f       	sbci	r27, 0xFD	; 253
     a22:	a3 0f       	add	r26, r19
     a24:	b1 1d       	adc	r27, r1
     a26:	2c 93       	st	X, r18
     a28:	01 96       	adiw	r24, 0x01	; 1
     a2a:	f3 cf       	rjmp	.-26     	; 0xa12 <twi_transmit+0x20>
  }
  twi_txBufferLength += length;
     a2c:	80 91 4c 02 	lds	r24, 0x024C	; 0x80024c <twi_txBufferLength>
     a30:	68 0f       	add	r22, r24
     a32:	60 93 4c 02 	sts	0x024C, r22	; 0x80024c <twi_txBufferLength>
     a36:	80 e0       	ldi	r24, 0x00	; 0
     a38:	08 95       	ret
{
  uint8_t i;

  // ensure data will fit into buffer
  if(TWI_BUFFER_LENGTH < (twi_txBufferLength+length)){
    return 1;
     a3a:	81 e0       	ldi	r24, 0x01	; 1
     a3c:	08 95       	ret
  }
  
  // ensure we are currently a slave transmitter
  if(TWI_STX != twi_state){
    return 2;
     a3e:	82 e0       	ldi	r24, 0x02	; 2
    twi_txBuffer[twi_txBufferLength+i] = data[i];
  }
  twi_txBufferLength += length;
  
  return 0;
}
     a40:	08 95       	ret

00000a42 <_ZN7TwoWire5flushEv>:

  return value;
}

void TwoWire::flush(void)
{
     a42:	08 95       	ret

00000a44 <_ZN7TwoWire4peekEv>:
// or after requestFrom(address, numBytes)
int TwoWire::peek(void)
{
  int value = -1;
  
  if(rxBufferIndex < rxBufferLength){
     a44:	e0 91 87 02 	lds	r30, 0x0287	; 0x800287 <_ZN7TwoWire13rxBufferIndexE>
     a48:	80 91 86 02 	lds	r24, 0x0286	; 0x800286 <_ZN7TwoWire14rxBufferLengthE>
     a4c:	e8 17       	cp	r30, r24
     a4e:	30 f4       	brcc	.+12     	; 0xa5c <_ZN7TwoWire4peekEv+0x18>
    value = rxBuffer[rxBufferIndex];
     a50:	f0 e0       	ldi	r31, 0x00	; 0
     a52:	e4 57       	subi	r30, 0x74	; 116
     a54:	fd 4f       	sbci	r31, 0xFD	; 253
     a56:	80 81       	ld	r24, Z
     a58:	90 e0       	ldi	r25, 0x00	; 0
     a5a:	08 95       	ret
// must be called in:
// slave rx event callback
// or after requestFrom(address, numBytes)
int TwoWire::peek(void)
{
  int value = -1;
     a5c:	8f ef       	ldi	r24, 0xFF	; 255
     a5e:	9f ef       	ldi	r25, 0xFF	; 255
  if(rxBufferIndex < rxBufferLength){
    value = rxBuffer[rxBufferIndex];
  }

  return value;
}
     a60:	08 95       	ret

00000a62 <_ZN7TwoWire4readEv>:
int TwoWire::read(void)
{
  int value = -1;
  
  // get each successive byte on each call
  if(rxBufferIndex < rxBufferLength){
     a62:	90 91 87 02 	lds	r25, 0x0287	; 0x800287 <_ZN7TwoWire13rxBufferIndexE>
     a66:	80 91 86 02 	lds	r24, 0x0286	; 0x800286 <_ZN7TwoWire14rxBufferLengthE>
     a6a:	98 17       	cp	r25, r24
     a6c:	50 f4       	brcc	.+20     	; 0xa82 <_ZN7TwoWire4readEv+0x20>
    value = rxBuffer[rxBufferIndex];
     a6e:	e9 2f       	mov	r30, r25
     a70:	f0 e0       	ldi	r31, 0x00	; 0
     a72:	e4 57       	subi	r30, 0x74	; 116
     a74:	fd 4f       	sbci	r31, 0xFD	; 253
     a76:	20 81       	ld	r18, Z
     a78:	30 e0       	ldi	r19, 0x00	; 0
    ++rxBufferIndex;
     a7a:	9f 5f       	subi	r25, 0xFF	; 255
     a7c:	90 93 87 02 	sts	0x0287, r25	; 0x800287 <_ZN7TwoWire13rxBufferIndexE>
     a80:	02 c0       	rjmp	.+4      	; 0xa86 <_ZN7TwoWire4readEv+0x24>
// must be called in:
// slave rx event callback
// or after requestFrom(address, numBytes)
int TwoWire::read(void)
{
  int value = -1;
     a82:	2f ef       	ldi	r18, 0xFF	; 255
     a84:	3f ef       	ldi	r19, 0xFF	; 255
    value = rxBuffer[rxBufferIndex];
    ++rxBufferIndex;
  }

  return value;
}
     a86:	c9 01       	movw	r24, r18
     a88:	08 95       	ret

00000a8a <_ZN7TwoWire9availableEv>:
// must be called in:
// slave rx event callback
// or after requestFrom(address, numBytes)
int TwoWire::available(void)
{
  return rxBufferLength - rxBufferIndex;
     a8a:	80 91 86 02 	lds	r24, 0x0286	; 0x800286 <_ZN7TwoWire14rxBufferLengthE>
     a8e:	90 e0       	ldi	r25, 0x00	; 0
     a90:	20 91 87 02 	lds	r18, 0x0287	; 0x800287 <_ZN7TwoWire13rxBufferIndexE>
}
     a94:	82 1b       	sub	r24, r18
     a96:	91 09       	sbc	r25, r1
     a98:	08 95       	ret
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
void loop() {
    // read raw accel/gyro measurements from device
#ifdef DEBUG_LOOP_TIME    
    16ce:	0e 94 de 02 	call	0x5bc	; 0x5bc <micros>
    16d2:	60 93 82 02 	sts	0x0282, r22	; 0x800282 <startTime>
    16d6:	70 93 83 02 	sts	0x0283, r23	; 0x800283 <startTime+0x1>
    16da:	80 93 84 02 	sts	0x0284, r24	; 0x800284 <startTime+0x2>
    16de:	90 93 85 02 	sts	0x0285, r25	; 0x800285 <startTime+0x3>
}

void TwoWire::beginTransmission(uint8_t address)
{
  // indicate that we are transmitting
  transmitting = 1;
    16e2:	f1 e0       	ldi	r31, 0x01	; 1
    16e4:	f0 93 d3 02 	sts	0x02D3, r31	; 0x8002d3 <_ZN7TwoWire12transmittingE>
  // set address of targeted slave
  txAddress = address;
    16e8:	88 e6       	ldi	r24, 0x68	; 104
    16ea:	c8 2e       	mov	r12, r24
    16ec:	c0 92 f5 02 	sts	0x02F5, r12	; 0x8002f5 <_ZN7TwoWire9txAddressE>
  // reset tx buffer iterator vars
  txBufferIndex = 0;
  txBufferLength = 0;
    16f0:	10 92 d4 02 	sts	0x02D4, r1	; 0x8002d4 <_ZN7TwoWire13txBufferIndexE>
    void onRequest( void (*)(void) );

    inline size_t write(unsigned long n) { return write((uint8_t)n); }
    inline size_t write(long n) { return write((uint8_t)n); }
    inline size_t write(unsigned int n) { return write((uint8_t)n); }
    inline size_t write(int n) { return write((uint8_t)n); }
    16f4:	10 92 f6 02 	sts	0x02F6, r1	; 0x8002f6 <_ZN7TwoWire14txBufferLengthE>
    16f8:	6b e3       	ldi	r22, 0x3B	; 59
    16fa:	84 e9       	ldi	r24, 0x94	; 148



    // Get accelerometer data - 296us in fast i2C mode
    Wire.beginTransmission(MPU_ADDR);
    Wire.write(0x3B);
    16fc:	93 e0       	ldi	r25, 0x03	; 3
    16fe:	f9 d9       	rcall	.-3086   	; 0xaf2 <_ZN7TwoWire5writeEh>
    1700:	80 e0       	ldi	r24, 0x00	; 0
    1702:	2c dd       	rcall	.-1448   	; 0x115c <_ZN7TwoWire15endTransmissionEh.constprop.39>
    1704:	41 e0       	ldi	r20, 0x01	; 1
    1706:	66 e0       	ldi	r22, 0x06	; 6
    quantity = BUFFER_LENGTH;
  }
  // perform blocking read into buffer
  uint8_t read = twi_readFrom(address, rxBuffer, quantity, sendStop);
  // set rx buffer iterator vars
  rxBufferIndex = 0;
    1708:	88 e6       	ldi	r24, 0x68	; 104
    170a:	a0 dd       	rcall	.-1216   	; 0x124c <twi_readFrom.part.0.constprop.35>
  rxBufferLength = read;
    170c:	10 92 87 02 	sts	0x0287, r1	; 0x800287 <_ZN7TwoWire13rxBufferIndexE>
    Wire.endTransmission(false);
    Wire.requestFrom(MPU_ADDR, 6, true);
    1710:	80 93 86 02 	sts	0x0286, r24	; 0x800286 <_ZN7TwoWire14rxBufferLengthE>
    1714:	84 e9       	ldi	r24, 0x94	; 148
    1716:	93 e0       	ldi	r25, 0x03	; 3
    1718:	a4 d9       	rcall	.-3256   	; 0xa62 <_ZN7TwoWire4readEv>
    171a:	18 2f       	mov	r17, r24
    171c:	84 e9       	ldi	r24, 0x94	; 148
    171e:	93 e0       	ldi	r25, 0x03	; 3
    1720:	a0 d9       	rcall	.-3264   	; 0xa62 <_ZN7TwoWire4readEv>
    1722:	1c a3       	std	Y+36, r17	; 0x24
    1724:	1b a2       	std	Y+35, r1	; 0x23
    1726:	0b a1       	ldd	r16, Y+35	; 0x23
    1728:	1c a1       	ldd	r17, Y+36	; 0x24
    172a:	08 2b       	or	r16, r24
    172c:	19 2b       	or	r17, r25
    172e:	10 93 81 02 	sts	0x0281, r17	; 0x800281 <ax+0x1>
    ax = (Wire.read() << 8 | Wire.read());
    1732:	00 93 80 02 	sts	0x0280, r16	; 0x800280 <ax>
    1736:	84 e9       	ldi	r24, 0x94	; 148
    1738:	93 e0       	ldi	r25, 0x03	; 3
    173a:	93 d9       	rcall	.-3290   	; 0xa62 <_ZN7TwoWire4readEv>
    173c:	f8 2e       	mov	r15, r24
    173e:	84 e9       	ldi	r24, 0x94	; 148
    1740:	93 e0       	ldi	r25, 0x03	; 3
    1742:	8f d9       	rcall	.-3298   	; 0xa62 <_ZN7TwoWire4readEv>
    1744:	fe a2       	std	Y+38, r15	; 0x26
    1746:	1d a2       	std	Y+37, r1	; 0x25
    1748:	ed a0       	ldd	r14, Y+37	; 0x25
    174a:	fe a0       	ldd	r15, Y+38	; 0x26
    174c:	e8 2a       	or	r14, r24
    174e:	f9 2a       	or	r15, r25
    1750:	f0 92 7f 02 	sts	0x027F, r15	; 0x80027f <ay+0x1>
    ay = (Wire.read() << 8 | Wire.read());
    1754:	e0 92 7e 02 	sts	0x027E, r14	; 0x80027e <ay>
    1758:	84 e9       	ldi	r24, 0x94	; 148
    175a:	93 e0       	ldi	r25, 0x03	; 3
    175c:	82 d9       	rcall	.-3324   	; 0xa62 <_ZN7TwoWire4readEv>
    175e:	d8 2e       	mov	r13, r24
    1760:	84 e9       	ldi	r24, 0x94	; 148
    1762:	93 e0       	ldi	r25, 0x03	; 3
    accelgyro.setDLPFMode(3);

    delay(40); // time delay for DLPF initial values
}

inline float atand(int y, int x) {
    1764:	7e d9       	rcall	.-3332   	; 0xa62 <_ZN7TwoWire4readEv>
    1766:	3d 2c       	mov	r3, r13
    1768:	21 2c       	mov	r2, r1
    176a:	82 29       	or	r24, r2
    176c:	93 29       	or	r25, r3
    176e:	bc 01       	movw	r22, r24
    1770:	99 0f       	add	r25, r25
    1772:	88 0b       	sbc	r24, r24
    1774:	99 0b       	sbc	r25, r25
    1776:	4e d2       	rcall	.+1180   	; 0x1c14 <__floatsisf>
    1778:	4b 01       	movw	r8, r22
    177a:	5c 01       	movw	r10, r24
    177c:	b7 01       	movw	r22, r14
    177e:	ff 0c       	add	r15, r15
    1780:	88 0b       	sbc	r24, r24
    1782:	99 0b       	sbc	r25, r25
    1784:	47 d2       	rcall	.+1166   	; 0x1c14 <__floatsisf>
    Serial.print("a/g:\t");
    Serial.print(ax); Serial.print("\t");
    Serial.print(ay); Serial.print("\t");
    Serial.println(az);
#endif       

    1786:	a5 01       	movw	r20, r10
    1788:	94 01       	movw	r18, r8
    178a:	58 d1       	rcall	.+688    	; 0x1a3c <atan2>
    178c:	20 ee       	ldi	r18, 0xE0	; 224
    178e:	3e e2       	ldi	r19, 0x2E	; 46
    1790:	45 e6       	ldi	r20, 0x65	; 101
    1792:	52 e4       	ldi	r21, 0x42	; 66
    1794:	4a d3       	rcall	.+1684   	; 0x1e2a <__mulsf3>
    accelgyro.setDLPFMode(3);

    delay(40); // time delay for DLPF initial values
}

inline float atand(int y, int x) {
    1796:	90 58       	subi	r25, 0x80	; 128
    1798:	78 d2       	rcall	.+1264   	; 0x1c8a <floor>
    179a:	6b 01       	movw	r12, r22
    179c:	7c 01       	movw	r14, r24
    179e:	b8 01       	movw	r22, r16
    17a0:	11 0f       	add	r17, r17
    17a2:	88 0b       	sbc	r24, r24
    17a4:	99 0b       	sbc	r25, r25
    17a6:	36 d2       	rcall	.+1132   	; 0x1c14 <__floatsisf>
    Serial.print(ax); Serial.print("\t");
    Serial.print(ay); Serial.print("\t");
    Serial.println(az);
#endif       

    pitchAngle = floor(-atand(ay, az)); // 192us     
    17a8:	a5 01       	movw	r20, r10
    17aa:	94 01       	movw	r18, r8
    17ac:	47 d1       	rcall	.+654    	; 0x1a3c <atan2>
    17ae:	20 ee       	ldi	r18, 0xE0	; 224
    17b0:	3e e2       	ldi	r19, 0x2E	; 46
    17b2:	45 e6       	ldi	r20, 0x65	; 101
    17b4:	52 e4       	ldi	r21, 0x42	; 66
    17b6:	39 d3       	rcall	.+1650   	; 0x1e2a <__mulsf3>
    17b8:	90 58       	subi	r25, 0x80	; 128
    17ba:	67 d2       	rcall	.+1230   	; 0x1c8a <floor>
    17bc:	f8 d1       	rcall	.+1008   	; 0x1bae <__fixsfsi>
    17be:	4b 01       	movw	r8, r22
    17c0:	5c 01       	movw	r10, r24
    17c2:	70 93 7d 02 	sts	0x027D, r23	; 0x80027d <rollAngle+0x1>
    17c6:	60 93 7c 02 	sts	0x027C, r22	; 0x80027c <rollAngle>
    rollAngle = floor(-atand(ax, az));
    17ca:	c7 01       	movw	r24, r14
    17cc:	b6 01       	movw	r22, r12
    17ce:	ef d1       	rcall	.+990    	; 0x1bae <__fixsfsi>
    17d0:	60 5b       	subi	r22, 0xB0	; 176
    17d2:	7f 4f       	sbci	r23, 0xFF	; 255
    17d4:	84 e3       	ldi	r24, 0x34	; 52
    17d6:	94 e0       	ldi	r25, 0x04	; 4
    17d8:	0e 94 03 03 	call	0x606	; 0x606 <_ZN5Servo5writeEi>
    pServo.write(P_SERVO_ZERO + pitchAngle); // 34us    
    17dc:	b4 01       	movw	r22, r8
    17de:	66 5a       	subi	r22, 0xA6	; 166
    17e0:	7f 4f       	sbci	r23, 0xFF	; 255
    17e2:	81 e3       	ldi	r24, 0x31	; 49
    17e4:	94 e0       	ldi	r25, 0x04	; 4
    17e6:	0e 94 03 03 	call	0x606	; 0x606 <_ZN5Servo5writeEi>
  return write(s.c_str(), s.length());
}

size_t Print::print(const char str[])
{
  return write(str);
    17ea:	84 e2       	ldi	r24, 0x24	; 36
    17ec:	92 e0       	ldi	r25, 0x02	; 2
    17ee:	05 de       	rcall	.-1014   	; 0x13fa <_ZN5Print5writeEPKc.constprop.14>

#ifdef OUTPUT_PITCH_ANGLE
    Serial.print("p:"); Serial.println(pitchAngle);
#endif 

#ifdef DEBUG_LOOP_TIME       
    17f0:	0e 94 de 02 	call	0x5bc	; 0x5bc <micros>
    17f4:	00 91 82 02 	lds	r16, 0x0282	; 0x800282 <startTime>
    17f8:	10 91 83 02 	lds	r17, 0x0283	; 0x800283 <startTime+0x1>
    17fc:	20 91 84 02 	lds	r18, 0x0284	; 0x800284 <startTime+0x2>
    1800:	30 91 85 02 	lds	r19, 0x0285	; 0x800285 <startTime+0x3>
    1804:	6b 01       	movw	r12, r22
    1806:	7c 01       	movw	r14, r24
    1808:	c0 1a       	sub	r12, r16
    180a:	d1 0a       	sbc	r13, r17
    180c:	e2 0a       	sbc	r14, r18
    180e:	f3 0a       	sbc	r15, r19
size_t Print::printNumber(unsigned long n, uint8_t base)
{
  char buf[8 * sizeof(long) + 1]; // Assumes 8-bit chars plus zero byte.
  char *str = &buf[sizeof(buf) - 1];

  *str = '\0';
    1810:	a7 01       	movw	r20, r14
    1812:	96 01       	movw	r18, r12
    1814:	19 a2       	std	Y+33, r1	; 0x21
    1816:	8e 01       	movw	r16, r28
  // prevent crash if called with base == 1
  if (base < 2) base = 10;

  do {
    char c = n % base;
    n /= base;
    1818:	0f 5d       	subi	r16, 0xDF	; 223
    181a:	1f 4f       	sbci	r17, 0xFF	; 255
    181c:	ca 01       	movw	r24, r20
    181e:	b9 01       	movw	r22, r18
    1820:	a3 01       	movw	r20, r6
    1822:	92 01       	movw	r18, r4

    *--str = c < 10 ? c + '0' : c + 'A' - 10;
    1824:	cb d0       	rcall	.+406    	; 0x19bc <__udivmodsi4>
    1826:	60 5d       	subi	r22, 0xD0	; 208
    1828:	f8 01       	movw	r30, r16
    182a:	62 93       	st	-Z, r22
  *str = '\0';

  // prevent crash if called with base == 1
  if (base < 2) base = 10;

  do {
    182c:	8f 01       	movw	r16, r30
    182e:	21 15       	cp	r18, r1
    1830:	31 05       	cpc	r19, r1
    1832:	41 05       	cpc	r20, r1
    1834:	51 05       	cpc	r21, r1
    n /= base;

    *--str = c < 10 ? c + '0' : c + 'A' - 10;
  } while(n);

  return write(str);
    1836:	91 f7       	brne	.-28     	; 0x181c <main+0x400>
    1838:	cf 01       	movw	r24, r30
    183a:	df dd       	rcall	.-1090   	; 0x13fa <_ZN5Print5writeEPKc.constprop.14>
  return x.printTo(*this);
}

size_t Print::println(void)
{
  return write("\r\n");
    183c:	88 e2       	ldi	r24, 0x28	; 40
    183e:	92 e0       	ldi	r25, 0x02	; 2
    1840:	dc dd       	rcall	.-1096   	; 0x13fa <_ZN5Print5writeEPKc.constprop.14>
    1842:	0e 94 28 02 	call	0x450	; 0x450 <_Z14serialEventRunv>
	
	setup();
    
	for (;;) {
		loop();
		if (serialEventRun) serialEventRun();
    1846:	43 cf       	rjmp	.-378    	; 0x16ce <main+0x2b2>

00001848 <_GLOBAL__I_65535_0_slc_vs.cpp.o.2489>:
    size_t printNumber(unsigned long, uint8_t);
    size_t printFloat(double, uint8_t);
  protected:
    void setWriteError(int err = 1) { write_error = err; }
  public:
    Print() : write_error(0) {}
    1848:	10 92 fa 02 	sts	0x02FA, r1	; 0x8002fa <Serial+0x3>
    184c:	10 92 f9 02 	sts	0x02F9, r1	; 0x8002f9 <Serial+0x2>
  public:
    virtual int available() = 0;
    virtual int read() = 0;
    virtual int peek() = 0;

    Stream() {_timeout=1000;}
    1850:	88 ee       	ldi	r24, 0xE8	; 232
    1852:	93 e0       	ldi	r25, 0x03	; 3
    1854:	a0 e0       	ldi	r26, 0x00	; 0
    1856:	b0 e0       	ldi	r27, 0x00	; 0
    1858:	80 93 fb 02 	sts	0x02FB, r24	; 0x8002fb <Serial+0x4>
    185c:	90 93 fc 02 	sts	0x02FC, r25	; 0x8002fc <Serial+0x5>
    1860:	a0 93 fd 02 	sts	0x02FD, r26	; 0x8002fd <Serial+0x6>
    1864:	b0 93 fe 02 	sts	0x02FE, r27	; 0x8002fe <Serial+0x7>
  volatile uint8_t *ucsrc, volatile uint8_t *udr) :
    _ubrrh(ubrrh), _ubrrl(ubrrl),
    _ucsra(ucsra), _ucsrb(ucsrb), _ucsrc(ucsrc),
    _udr(udr),
    _rx_buffer_head(0), _rx_buffer_tail(0),
    _tx_buffer_head(0), _tx_buffer_tail(0)
    1868:	24 e0       	ldi	r18, 0x04	; 4
    186a:	32 e0       	ldi	r19, 0x02	; 2
    186c:	30 93 f8 02 	sts	0x02F8, r19	; 0x8002f8 <Serial+0x1>
    1870:	20 93 f7 02 	sts	0x02F7, r18	; 0x8002f7 <Serial>
    1874:	25 ec       	ldi	r18, 0xC5	; 197
    1876:	30 e0       	ldi	r19, 0x00	; 0
    1878:	30 93 04 03 	sts	0x0304, r19	; 0x800304 <Serial+0xd>
    187c:	20 93 03 03 	sts	0x0303, r18	; 0x800303 <Serial+0xc>
    1880:	24 ec       	ldi	r18, 0xC4	; 196
    1882:	30 e0       	ldi	r19, 0x00	; 0
    1884:	30 93 06 03 	sts	0x0306, r19	; 0x800306 <Serial+0xf>
    1888:	20 93 05 03 	sts	0x0305, r18	; 0x800305 <Serial+0xe>
    188c:	20 ec       	ldi	r18, 0xC0	; 192
    188e:	30 e0       	ldi	r19, 0x00	; 0
    1890:	30 93 08 03 	sts	0x0308, r19	; 0x800308 <Serial+0x11>
    1894:	20 93 07 03 	sts	0x0307, r18	; 0x800307 <Serial+0x10>
    1898:	21 ec       	ldi	r18, 0xC1	; 193
    189a:	30 e0       	ldi	r19, 0x00	; 0
    189c:	30 93 0a 03 	sts	0x030A, r19	; 0x80030a <Serial+0x13>
    18a0:	20 93 09 03 	sts	0x0309, r18	; 0x800309 <Serial+0x12>
    18a4:	22 ec       	ldi	r18, 0xC2	; 194
    18a6:	30 e0       	ldi	r19, 0x00	; 0
    18a8:	30 93 0c 03 	sts	0x030C, r19	; 0x80030c <Serial+0x15>
    18ac:	20 93 0b 03 	sts	0x030B, r18	; 0x80030b <Serial+0x14>
    18b0:	26 ec       	ldi	r18, 0xC6	; 198
    18b2:	30 e0       	ldi	r19, 0x00	; 0
    18b4:	30 93 0e 03 	sts	0x030E, r19	; 0x80030e <Serial+0x17>
    18b8:	20 93 0d 03 	sts	0x030D, r18	; 0x80030d <Serial+0x16>
    18bc:	10 92 10 03 	sts	0x0310, r1	; 0x800310 <Serial+0x19>
    18c0:	10 92 11 03 	sts	0x0311, r1	; 0x800311 <Serial+0x1a>
    18c4:	10 92 12 03 	sts	0x0312, r1	; 0x800312 <Serial+0x1b>
    18c8:	10 92 13 03 	sts	0x0313, r1	; 0x800313 <Serial+0x1c>
    18cc:	10 92 97 03 	sts	0x0397, r1	; 0x800397 <Wire+0x3>
    18d0:	10 92 96 03 	sts	0x0396, r1	; 0x800396 <Wire+0x2>
    18d4:	80 93 98 03 	sts	0x0398, r24	; 0x800398 <Wire+0x4>
    18d8:	90 93 99 03 	sts	0x0399, r25	; 0x800399 <Wire+0x5>
    18dc:	a0 93 9a 03 	sts	0x039A, r26	; 0x80039a <Wire+0x6>
    18e0:	b0 93 9b 03 	sts	0x039B, r27	; 0x80039b <Wire+0x7>
void (*TwoWire::user_onRequest)(void);
void (*TwoWire::user_onReceive)(int);

// Constructors ////////////////////////////////////////////////////////////////

TwoWire::TwoWire()
    18e4:	86 e1       	ldi	r24, 0x16	; 22
    18e6:	92 e0       	ldi	r25, 0x02	; 2
    18e8:	90 93 95 03 	sts	0x0395, r25	; 0x800395 <Wire+0x1>
    18ec:	80 93 94 03 	sts	0x0394, r24	; 0x800394 <Wire>

/** Default constructor, uses default I2C address.
 * @see MPU6050_DEFAULT_ADDRESS
 */
MPU6050::MPU6050() {
    devAddr = MPU6050_DEFAULT_ADDRESS;
    18f0:	88 e6       	ldi	r24, 0x68	; 104
    18f2:	80 93 37 04 	sts	0x0437, r24	; 0x800437 <accelgyro>

/****************** end of static functions ******************************/

Servo::Servo()
{
  if( ServoCount < MAX_SERVOS) {
    18f6:	80 91 30 04 	lds	r24, 0x0430	; 0x800430 <ServoCount>
    18fa:	80 33       	cpi	r24, 0x30	; 48
    18fc:	a0 f4       	brcc	.+40     	; 0x1926 <_GLOBAL__I_65535_0_slc_vs.cpp.o.2489+0xde>
    this->servoIndex = ServoCount++;                    // assign a servo index to this instance
    18fe:	91 e0       	ldi	r25, 0x01	; 1
    1900:	98 0f       	add	r25, r24
    1902:	90 93 30 04 	sts	0x0430, r25	; 0x800430 <ServoCount>
    1906:	80 93 34 04 	sts	0x0434, r24	; 0x800434 <pServo>
	servos[this->servoIndex].ticks = usToTicks(DEFAULT_PULSE_WIDTH);   // store default values  - 12 Aug 2009
    190a:	90 e0       	ldi	r25, 0x00	; 0
    190c:	fc 01       	movw	r30, r24
    190e:	ee 0f       	add	r30, r30
    1910:	ff 1f       	adc	r31, r31
    1912:	8e 0f       	add	r24, r30
    1914:	9f 1f       	adc	r25, r31
    1916:	fc 01       	movw	r30, r24
    1918:	e0 56       	subi	r30, 0x60	; 96
    191a:	fc 4f       	sbci	r31, 0xFC	; 252
    191c:	88 eb       	ldi	r24, 0xB8	; 184
    191e:	9b e0       	ldi	r25, 0x0B	; 11
    1920:	92 83       	std	Z+2, r25	; 0x02
    1922:	81 83       	std	Z+1, r24	; 0x01
    1924:	03 c0       	rjmp	.+6      	; 0x192c <_GLOBAL__I_65535_0_slc_vs.cpp.o.2489+0xe4>
  }
  else
    this->servoIndex = INVALID_SERVO ;  // too many servos
    1926:	8f ef       	ldi	r24, 0xFF	; 255
    1928:	80 93 34 04 	sts	0x0434, r24	; 0x800434 <pServo>

/****************** end of static functions ******************************/

Servo::Servo()
{
  if( ServoCount < MAX_SERVOS) {
    192c:	80 91 30 04 	lds	r24, 0x0430	; 0x800430 <ServoCount>
    1930:	80 33       	cpi	r24, 0x30	; 48
    1932:	a0 f4       	brcc	.+40     	; 0x195c <_GLOBAL__I_65535_0_slc_vs.cpp.o.2489+0x114>
    this->servoIndex = ServoCount++;                    // assign a servo index to this instance
    1934:	91 e0       	ldi	r25, 0x01	; 1
    1936:	98 0f       	add	r25, r24
    1938:	90 93 30 04 	sts	0x0430, r25	; 0x800430 <ServoCount>
    193c:	80 93 31 04 	sts	0x0431, r24	; 0x800431 <rServo>
	servos[this->servoIndex].ticks = usToTicks(DEFAULT_PULSE_WIDTH);   // store default values  - 12 Aug 2009
    1940:	90 e0       	ldi	r25, 0x00	; 0
    1942:	fc 01       	movw	r30, r24
    1944:	ee 0f       	add	r30, r30
    1946:	ff 1f       	adc	r31, r31
    1948:	8e 0f       	add	r24, r30
    194a:	9f 1f       	adc	r25, r31
    194c:	fc 01       	movw	r30, r24
    194e:	e0 56       	subi	r30, 0x60	; 96
    1950:	fc 4f       	sbci	r31, 0xFC	; 252
    1952:	88 eb       	ldi	r24, 0xB8	; 184
    1954:	9b e0       	ldi	r25, 0x0B	; 11
    1956:	92 83       	std	Z+2, r25	; 0x02
    1958:	81 83       	std	Z+1, r24	; 0x01
    195a:	08 95       	ret
  }
  else
    this->servoIndex = INVALID_SERVO ;  // too many servos
    195c:	8f ef       	ldi	r24, 0xFF	; 255
    195e:	80 93 31 04 	sts	0x0431, r24	; 0x800431 <rServo>
    1962:	08 95       	ret

00001964 <__divmodsi4>:
    1964:	05 2e       	mov	r0, r21
    1966:	97 fb       	bst	r25, 7
    1968:	16 f4       	brtc	.+4      	; 0x196e <__divmodsi4+0xa>
    196a:	00 94       	com	r0
    196c:	0f d0       	rcall	.+30     	; 0x198c <__negsi2>
    196e:	57 fd       	sbrc	r21, 7
    1970:	05 d0       	rcall	.+10     	; 0x197c <__divmodsi4_neg2>
    1972:	24 d0       	rcall	.+72     	; 0x19bc <__udivmodsi4>
    1974:	07 fc       	sbrc	r0, 7
    1976:	02 d0       	rcall	.+4      	; 0x197c <__divmodsi4_neg2>
    1978:	46 f4       	brtc	.+16     	; 0x198a <__divmodsi4_exit>
    197a:	08 c0       	rjmp	.+16     	; 0x198c <__negsi2>

0000197c <__divmodsi4_neg2>:
    197c:	50 95       	com	r21
    197e:	40 95       	com	r20
    1980:	30 95       	com	r19
    1982:	21 95       	neg	r18
    1984:	3f 4f       	sbci	r19, 0xFF	; 255
    1986:	4f 4f       	sbci	r20, 0xFF	; 255
    1988:	5f 4f       	sbci	r21, 0xFF	; 255

0000198a <__divmodsi4_exit>:
    198a:	08 95       	ret

0000198c <__negsi2>:
    198c:	90 95       	com	r25
    198e:	80 95       	com	r24
    1990:	70 95       	com	r23
    1992:	61 95       	neg	r22
    1994:	7f 4f       	sbci	r23, 0xFF	; 255
    1996:	8f 4f       	sbci	r24, 0xFF	; 255
    1998:	9f 4f       	sbci	r25, 0xFF	; 255
    199a:	08 95       	ret

0000199c <__muluhisi3>:
    199c:	31 d0       	rcall	.+98     	; 0x1a00 <__umulhisi3>
    199e:	a5 9f       	mul	r26, r21
    19a0:	90 0d       	add	r25, r0
    19a2:	b4 9f       	mul	r27, r20
    19a4:	90 0d       	add	r25, r0
    19a6:	a4 9f       	mul	r26, r20
    19a8:	80 0d       	add	r24, r0
    19aa:	91 1d       	adc	r25, r1
    19ac:	11 24       	eor	r1, r1
    19ae:	08 95       	ret

000019b0 <__mulshisi3>:
    19b0:	b7 ff       	sbrs	r27, 7
    19b2:	f4 cf       	rjmp	.-24     	; 0x199c <__muluhisi3>

000019b4 <__mulohisi3>:
    19b4:	f3 df       	rcall	.-26     	; 0x199c <__muluhisi3>
    19b6:	82 1b       	sub	r24, r18
    19b8:	93 0b       	sbc	r25, r19
    19ba:	08 95       	ret

000019bc <__udivmodsi4>:
    19bc:	a1 e2       	ldi	r26, 0x21	; 33
    19be:	1a 2e       	mov	r1, r26
    19c0:	aa 1b       	sub	r26, r26
    19c2:	bb 1b       	sub	r27, r27
    19c4:	fd 01       	movw	r30, r26
    19c6:	0d c0       	rjmp	.+26     	; 0x19e2 <__udivmodsi4_ep>

000019c8 <__udivmodsi4_loop>:
    19c8:	aa 1f       	adc	r26, r26
    19ca:	bb 1f       	adc	r27, r27
    19cc:	ee 1f       	adc	r30, r30
    19ce:	ff 1f       	adc	r31, r31
    19d0:	a2 17       	cp	r26, r18
    19d2:	b3 07       	cpc	r27, r19
    19d4:	e4 07       	cpc	r30, r20
    19d6:	f5 07       	cpc	r31, r21
    19d8:	20 f0       	brcs	.+8      	; 0x19e2 <__udivmodsi4_ep>
    19da:	a2 1b       	sub	r26, r18
    19dc:	b3 0b       	sbc	r27, r19
    19de:	e4 0b       	sbc	r30, r20
    19e0:	f5 0b       	sbc	r31, r21

000019e2 <__udivmodsi4_ep>:
    19e2:	66 1f       	adc	r22, r22
    19e4:	77 1f       	adc	r23, r23
    19e6:	88 1f       	adc	r24, r24
    19e8:	99 1f       	adc	r25, r25
    19ea:	1a 94       	dec	r1
    19ec:	69 f7       	brne	.-38     	; 0x19c8 <__udivmodsi4_loop>
    19ee:	60 95       	com	r22
    19f0:	70 95       	com	r23
    19f2:	80 95       	com	r24
    19f4:	90 95       	com	r25
    19f6:	9b 01       	movw	r18, r22
    19f8:	ac 01       	movw	r20, r24
    19fa:	bd 01       	movw	r22, r26
    19fc:	cf 01       	movw	r24, r30
    19fe:	08 95       	ret

00001a00 <__umulhisi3>:
    1a00:	a2 9f       	mul	r26, r18
    1a02:	b0 01       	movw	r22, r0
    1a04:	b3 9f       	mul	r27, r19
    1a06:	c0 01       	movw	r24, r0
    1a08:	a3 9f       	mul	r26, r19
    1a0a:	70 0d       	add	r23, r0
    1a0c:	81 1d       	adc	r24, r1
    1a0e:	11 24       	eor	r1, r1
    1a10:	91 1d       	adc	r25, r1
    1a12:	b2 9f       	mul	r27, r18
    1a14:	70 0d       	add	r23, r0
    1a16:	81 1d       	adc	r24, r1
    1a18:	11 24       	eor	r1, r1
    1a1a:	91 1d       	adc	r25, r1
    1a1c:	08 95       	ret
    1a1e:	9f d1       	rcall	.+830    	; 0x1d5e <__fp_pscA>
    1a20:	58 f0       	brcs	.+22     	; 0x1a38 <__umulhisi3+0x38>
    1a22:	80 e8       	ldi	r24, 0x80	; 128
    1a24:	91 e0       	ldi	r25, 0x01	; 1
    1a26:	09 f4       	brne	.+2      	; 0x1a2a <__umulhisi3+0x2a>
    1a28:	9e ef       	ldi	r25, 0xFE	; 254
    1a2a:	a0 d1       	rcall	.+832    	; 0x1d6c <__fp_pscB>
    1a2c:	28 f0       	brcs	.+10     	; 0x1a38 <__umulhisi3+0x38>
    1a2e:	40 e8       	ldi	r20, 0x80	; 128
    1a30:	51 e0       	ldi	r21, 0x01	; 1
    1a32:	59 f4       	brne	.+22     	; 0x1a4a <atan2+0xe>
    1a34:	5e ef       	ldi	r21, 0xFE	; 254
    1a36:	09 c0       	rjmp	.+18     	; 0x1a4a <atan2+0xe>
    1a38:	6a c1       	rjmp	.+724    	; 0x1d0e <__fp_nan>
    1a3a:	e9 c1       	rjmp	.+978    	; 0x1e0e <__fp_zero>

00001a3c <atan2>:
    1a3c:	e9 2f       	mov	r30, r25
    1a3e:	e0 78       	andi	r30, 0x80	; 128
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
    1e3e:	11 24       	eor	r1, r1
    1e40:	e7 cf       	rjmp	.-50     	; 0x1e10 <__fp_szero>

00001e42 <__mulsf3x>:
    1e42:	ac df       	rcall	.-168    	; 0x1d9c <__fp_split3>
    1e44:	a0 f3       	brcs	.-24     	; 0x1e2e <__mulsf3+0x4>
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
